copperheadhq/copperhead-tps5430-buck-converter/docs/README.md

# Documentation

The design documents of the TPS5430 12 V to 5 V Industrial Buck Converter at rev E (release commit `c50e737`, design at `116202e`), published as they were written alongside the design.

| File | What |
| --- | --- |
| `BRIEF.md` | the brief the design was built from, unedited |
| `BOM.md` | design document from the workspace, unedited |
| `CHANGELOG.md` | design document from the workspace, unedited |
| `DECISIONS.md` | design document from the workspace, unedited |
| `PINOUT.md` | design document from the workspace, unedited |
| `SPEC.md` | design document from the workspace, unedited |
| `SUBSYSTEMS.md` | design document from the workspace, unedited |
| `BOARD-STATS.md` | measured board statistics: parts, pads, holes, vias, track widths, pours, teardrops, DRC and ERC |
| `schematic.pdf`, `schematic.svg` | the schematic, exported from `hardware/` with KiCad 10.0.6. Regenerate rather than edit |

These documents record choices as they were made, and name files that are not in this repository: `outputs/`, `openspec/`, `releases/`, `research/`, `docs/LAYOUT.md`, `docs/DEVPLAN.md` and `.copperhead/constraints.json`. The rev E fabrication files from `releases/rev-e/` are in [`../fab/rev-e/`](../fab/rev-e/); the earlier rev D files stay in [`../fab/rev-d/`](../fab/rev-d/).
