copperheadhq/copperhead-tps5430-buck-converter/docs/DECISIONS.md

- 2026-11-05 [run 2026-11-05T21-28-54-613Z] Seeded docs/SPEC.md from docs/BRIEF.md and filled the budgets the brief leaves unstated with ASSUMED defaults: Vout ±3 % (4.85–5.15 V); ripple ≤50 mVpp; efficiency ≥85 % at 12 V/3 A; no-load Iin ≤20 mA; shutdown Iin ≤1 mA; LED 1–3 mA; reverse-FET |Vgs| target ≤15 V (20 V abs); component voltage derating ≥1.5×; TPS5430 Tj ≤125 °C; component rise ≤40 °C; terminals ≥4.5 A; power copper ≤20 °C rise; clearance ≥0.2 mm; M3 keepout ≥3.5 mm radius; passives ≥0603. The fuse value (3 A vs 4 A) stays an open question, with 0154004.DRT recommended. | why: Later stages need numeric budgets to check parts against. These are conventional defaults for a 15 W SELV buck, and each one is flagged ASSUMED so the person can override it. | affects: docs/SPEC.md; .copperhead/constraints.json; F1, Q_rev, U1, L1, D_catch, C_in, C_out, J1, J2, LED
- 2026-11-05 [run 2026-11-05T21-32-46-743Z] TVS D1 (SMBJ18A) is placed on the protected side of the reverse-polarity FET Q1. The input order is J1 → F1 → Q1 → D1. | why: A unidirectional TVS ahead of Q1 would forward-conduct on a reversed supply and blow F1, which breaks the requirement of no damage from -18 V. Placing it downstream means Q1's channel carries the surge current, so the parts stage must check Q1's pulsed Id against the SMBJ18A Ipp. | affects: D1, Q1, F1, VIN_PROT, docs/SUBSYSTEMS.md §1
- 2026-11-05 [run 2026-11-05T21-32-46-743Z] EN has no external pull-up. The TPS5430 internal ENA pull-up gives the default-on state, and external control is open-drain or dry contact to GND only, via 2 pads plus TP_EN. An optional DNP 1 nF EN→GND footprint is provided. | why: ENA abs max is about 7 V (VERIFY) [corrected 2026-11-06, change review-docs-fab-notes: 7 V abs max and 1.5 MΩ internal pull-up, TI SLVS632L rev L, VERIFIED], so a pull-up to VIN (9–29 V) would overstress the pin, and no other rail exists before the converter starts. The internal pull-up meets SPEC 'pulled high by default' and adds nothing to the 1 mA shutdown budget. The missing pull-up is intentional, not an omission. | affects: U1 ENA, EN net, R_en (deliberately not fitted), docs/SUBSYSTEMS.md §5, SPEC §3 EN
- 2026-11-05 [run 2026-11-05T21-32-46-743Z] Specify feedback resistors R2 10.0 kΩ and R3 3.24 kΩ at 0.5 % tolerance (or tighter), 0603, ≤50 ppm/°C, instead of the 1 % stated in the brief. The values are unchanged. | why: With 1 % parts, the TPS5430 reference (±1.5 %, VERIFY) plus the divider ratio error (±1.5 %) already uses the whole ±3 % (4.85–5.15 V) budget, leaving no room for line, load or ripple error. At 0.5 % the worst case is about ±2.3 % plus regulation error. | affects: R2, R3, FB, power.vout_V, docs/SUBSYSTEMS.md §4, docs/BRIEF.md Parts (deviation from 1 %)
- 2026-11-05 [run 2026-11-05T21-36-28-544Z] Stage 3 part selection: (a) D1 SMBJ18A-13-F is drawn with Device:D_Zener (K=1 on VIN_PROT, A=2 on GND) because no unidirectional TVS symbol is installed and Device:D_TVS is bidirectional (A1/A2). (b) L1 SRP1265A-150M uses footprint Inductor_SMD:L_Bourns_SRP1245A because no SRP1265A footprint is installed (same 12.5x12.5 mm SRP12xx body [corrected 2026-11-06, change review-docs-fab-notes: the SRP1265A body is 13.5 × 12.5 mm, Bourns SRP1265A rev 06/24, VERIFIED; long side along the pad axis, inside the courtyard]; pads must be compared with the SRP1265A datasheet before layout). (c) J1/J2 change from Würth 691137710002 to Phoenix MKDS 1,5/2-5.08 (1715721) because no Würth footprint is installed; the Phoenix part is rated ~17.5 A, well above 4.5 A. (d) Q1 DMP6023LE uses Transistor_FET:Q_PMOS_GDS (SOT-223 G/D/S, tab=D). (e) FB1 is a 2512 0 Ω jumper (RCL12250000Z0EG) for the bridged EMI series position. All MPNs UNVERIFIED. Leakage roll-up: shutdown about 0.11 mA (≤ 1 mA), no-load about 6–10 mA (≤ 20 mA). | why: Stage 4 can only draw installed symbols and footprints. Keeping the unidirectional K/A polarity explicit preserves the reverse-polarity analysis. A footprint that matches the actual MPN avoids pad and pitch mismatch. All budgets still hold. | affects: D1, L1, J1, J2, Q1, FB1, docs/BOM.md, docs/SPEC.md §5, docs/SUBSYSTEMS.md, deviation from docs/BRIEF.md Parts (terminals)
- 2026-11-05 [run 2026-11-05T21-40-51-050Z] Stage 4 schematic capture from schematic.intent.json, with these choices:
(a) D1 SMBJ18A stays Device:D_Zener (K=1 on VIN_PROT, A=2 on GND). The dossier suggested Diode:SMAJ18A, which was rejected because it has bidirectional A1/A2 pins and would hide the unidirectional polarity the reverse-polarity analysis depends on.
(b) Parts the dossier marked as having no installed MPN symbol (Q1, F1, D2, D3, D4, FB1, J1–J3, TP1–TP7) use the generic installed lib_ids from BOM.md. verify_symbols confirmed all 13 of them.
(c) LED_A is a new net, the R4 to D4 anode node, added beyond the SUBSYSTEMS planned list.
(d) U1.2 and U1.3 (NC) are explicit no-connects. There is still no EN pull-up (protection.ena_pin_max_V).
(e) verify_symbols reports wrong-library on the power symbols the engine generates: copperhead_power:+5V, GND, PWR_FLAG and VIN_BUCK, where it expects power:*. The IR cannot set these and edit_file is refused on the drafted sheet, so this is left as a known drafting-engine issue. ERC is clean. Retarget the symbols to power:* before netlist export to layout.
(f) A3 paper was kept despite the low-utilization advisory. | why: Keeps the protection polarity explicit and uses only installed, pin-verified symbols. It also records the one verification finding that is open but outside the IR's control, so layout does not miss it. | affects: D1, Q1, F1, D2, D3, D4, FB1, J1–J3, TP1–TP7, U1.2, U1.3, LED_A, EN, power symbols, docs/PINOUT.md, tps5430-12-v-to-5-v-industrial-buck-converter.kicad_sch
- 2026-11-05 [run 2026-11-05T22-11-48-485Z] Stage 5 first-draft layout. (a) Edge.Cuts resized to 55 × 35 mm, (100,100)–(155,135). (b) Two-band placement: input chain J1 (left edge) → F1 → Q1 (rot 180, tab to F1) → D1 → FB1 across the top, and J2 on the right edge. The buck core is in the bottom band: U1 (126,126.5) with C3 at VIN pin 7, C4 between BOOT and PH, D3 (rot 270) right of C3, and L1 in the bottom-right corner. C5/C6 sit between L1 and J2. The R2/R3/TP6 feedback divider is left of VSENSE, away from SW. (c) Only BOOT, the SW bootstrap leg, FB, VIN_RAW, VIN_FUSED, the VIN_BUCK HF bypass and LED_A are routed (52 → 44 unrouted). No GND pour yet. VIN_PROT, the VIN_BUCK bulk path, SW to D3/L1 and +5V are left as ratsnest for a specialist pass. (d) TP4 is placed in the lower-left strip, not at J2, for lack of space. (e) No M3 mounting holes are placed, because no mounting-hole footprints exist in the schematic/BOM. They have to be added through the schematic. (f) 25 silkscreen warnings are left and listed in LAYOUT.md. | why: Keeps the protection order and the tight VIN–C3–U1–D3 loop that the architecture requires, while staying DRC-error-free within the 55 × 35 mm envelope. The unrouted high-current copper and the missing GND pour are recorded as non-optimal items in docs/LAYOUT.md Draft quality, not left unlabelled. | affects: J1, J2, F1, Q1, D1–D4, L1, FB1, C1–C9, R1–R4, J3, TP1–TP7, U1, Edge.Cuts, docs/LAYOUT.md, tps5430-12-v-to-5-v-industrial-buck-converter.kicad_pcb
- 2026-11-05 [run 2026-11-05T22-46-32-892Z] F1 changes from Littelfuse 0154003.DRT (3 A) to 0154004.DRT (4 A slow-blow). The OMNI-BLOK holder, the footprint Fuse:Fuseholder_Littelfuse_Nano2_154x and the nets VIN_RAW/VIN_FUSED do not change. SPEC §9 Q1 is closed as decided. FB1, or any series inductor or ferrite fitted there later, must now be rated at least 4 A instead of 3 A; the RCL12250000Z0EG at about 7 A class still passes. The schematic Value was changed through schematic.intent.json and a re-draft, because the sheet is engine-drafted and direct edits are refused. The board F1 Value text was changed in place, with no pad, net or position change. | why: At the 1.96 A worst-case input the 3 A fuse ran at about 87 % of rating, above the 75 % continuous guideline and worse at 50 °C. The 4 A fuse runs at about 49 %. The fuse also has to open before the series link fails, so FB1's required rating rises with it. The change follows docs/BRIEF.md Parts (decided 2026-11-05, research/parts/input-fuse.md). | affects: F1, FB1, J1, Q1, PCB input copper, protection.fuse_rating_A, schematic.intent.json, tps5430-12-v-to-5-v-industrial-buck-converter.kicad_sch, tps5430-12-v-to-5-v-industrial-buck-converter.kicad_pcb, docs/BOM.md, docs/SPEC.md §3 and §9, docs/SUBSYSTEMS.md §0, §1, §2 and §9, docs/PINOUT.md
- 2026-11-05 [run 2026-11-05T22-49-58-758Z] L1 footprint Inductor_SMD:L_Bourns_SRP1245A is accepted as VERIFIED for the SRP1265A-150M. The SRP1265A and SRP1245A datasheets give the same recommended land pattern: 14.2 mm overall, 8.0 mm gap, 5.0 mm pad width. The KiCad pads are 3.1 × 5 mm at ±5.55 mm, which matches. Body height differs (SRP1265A 6.2 mm vs SRP1245A 4.8 mm), so the 3D model is 1.4 mm short. Copper is unaffected. LAYOUT.md Draft quality item 10 is closed. No footprint, net, schematic or board change. L1 electrical figures (Isat, Irms, DCR) stay UNVERIFIED. | why: The copper matches the manufacturer's recommended layout, so the pad-mismatch risk from stage 3 is gone. The height difference only matters for enclosure and height clearance, so it stays recorded as a note. | affects: L1, docs/BOM.md, docs/LAYOUT.md item 10
- 2026-11-05 [run 2026-11-05T22-56-18-542Z] The schematic keeps the copperhead_power:* power symbols (+5V, GND, PWR_FLAG, VIN_BUCK). This is an accepted drafting-engine limitation, and they will not be retargeted to power:*. docs/LAYOUT.md Draft quality item 11 is closed. This supersedes the stage-4 decision (e) instruction to retarget them before netlist export. The verify_symbols wrong-library finding on these four symbols is expected and needs no action. No schematic, net, board or constraint change. Accepted by the person on 2026-11-05. | why: The drafting engine can only place copperhead_power symbols. They are genuine KiCad power symbols in a project library, so they give the same nets and netlist as power:* would. KiCad has no stock power:VIN_BUCK, so a full retarget is not possible anyway. | affects: +5V, GND, PWR_FLAG, VIN_BUCK power symbols; tps5430-12-v-to-5-v-industrial-buck-converter.kicad_sch (unchanged); docs/LAYOUT.md item 11; docs/DECISIONS.md stage-4 (e)
- 2026-11-05 [run 2026-11-05T22-56-59-643Z] Added M3 mounting holes H1 (103,103) top-left and H2 (157,137) bottom-right, diagonally opposite. Both are Mechanical:MountingHole with footprint MountingHole:MountingHole_3.2mm_M3, NPTH, no net. They were added through schematic.intent.json (new SUBSYSTEMS §10 Mechanical group) and BOM.md rows. Each footprint carries an embedded keepout rule area, a 16-gon with 3.57 mm circumscribed radius so the inner radius is ≥ 3.5 mm, on F.Cu and B.Cu. It forbids tracks, vias, copper pour and footprints. Pads are allowed only so the hole's own NPTH pad does not flag. To free the bottom-right corner, the Edge.Cuts outline grew from 55 × 35 to 60 × 40 mm, (100,100)–(160,140). That corner was blocked: L1's courtyard reaches x 154.7 / y 134.5 and D3 blocks a slide left. J1 slid down the left edge to (106,115.5), with the VIN_RAW stub re-anchored. J2 slid right to (154,104). TP3 moved to (106,121.5). U1, C3, C4, D3, L1 and R2/R3/TP6 did not move. The two DRC lib_footprint_mismatch warnings on H1/H2 are intentional. mech.board_mm max is updated from 55 to 60. | why: docs/BRIEF.md Physical requires 2 × M3 on opposite corners with copper and component keepout. Growing the outline to the person's 60 × 40 mm limit was the only way to free a second corner without breaking the tight VIN–C3–U1–D3 loop or moving the FB divider toward SW. Embedding the keepout in the footprint avoids a board-level zone flagging the hole's own courtyard. The holes are unplated and unbonded so the mount is not a GND path. DRC shows 0 errors, unrouted stays at 44, and ERC is clean. | why: Meets the brief's mounting-hole and keepout requirement within the agreed size limit while leaving the buck hot loop and feedback placement untouched. | affects: H1, H2, J1, J2, TP3, VIN_RAW track, Edge.Cuts, mech.board_mm, schematic.intent.json, .kicad_sch, .kicad_pcb, docs/BOM.md, docs/SUBSYSTEMS.md §10, docs/LAYOUT.md (outline, placement, item 8), docs/SPEC.md §6 and §9 Q2, docs/PINOUT.md
- 2026-11-05 [run 2026-11-05T22-56-59-643Z] Supersedes the earlier entry today on H1/H2 keepouts. H1 (103,103) and H2 (157,137) now use the unmodified stock MountingHole:MountingHole_3.2mm_M3 footprints. Their keepouts are board-level rule areas on F.Cu and B.Cu. Each hole has a full r ≥ 3.5 mm copper-keepout disc (16-gon, 3.57 mm circumscribed) that forbids tracks, vias and copper pour but allows footprints and pads. Each hole also has a half-annulus pair (≈ 3.48–3.8 mm) that forbids footprints, sitting just outside the hole's own 3.45 mm courtyard. The embedded-in-footprint keepout from the first attempt is removed. The two lib_footprint_mismatch DRC warnings it caused are gone, and DRC is clean with 44 unrouted. | why: A keepout embedded in the stock footprint made it differ from the library copy, which raised lib_footprint_mismatch. A single board-level zone with footprints not_allowed would flag the hole's own courtyard. A copper disc plus a component annulus outside the hole courtyard enforces both keepouts with clean DRC. | affects: H1, H2, board keepout zones H1_*/H2_*, mech.board_mm, docs/LAYOUT.md item 8 and H1/H2 rows, docs/CHANGELOG.md, earlier DECISIONS entry of this run
- 2026-11-05 [run 2026-11-05T23-26-09-525Z] Added two unfilled GND zone outlines, GND_pour_F.Cu and GND_pour_B.Cu. Each is a rectangle (100.5,100.5)–(159.5,139.5), inset 0.5 mm from Edge.Cuts. Settings: net GND, thermal-relief pad connection (gap 0.5 mm, spoke 0.5 mm), zone clearance 0.3 mm, min thickness 0.25 mm. The existing H1_/H2_copper_keepout_r3.5 rule areas (copperpour not_allowed) carve the pours around the mounting holes. U1 pad 9 (the exposed pad and its footprint thermal-via pads) connects solid to GND through a new rule, U1_pad9_solid_to_GND, in the existing project .kicad_dru, which also keeps its via-drill rule. I also added an explicit (stackup) to the board (setup): F.Cu and B.Cu 0.07 mm (2 oz), 1.44 mm FR4 core, 0.01 mm mask each side, 1.6 mm overall. Design rules are otherwise unchanged. No stitching vias were added and the zones were not filled; KiCad's filler (kicad-cli pcb drc --refill-zones --save-board) must fill them, and stitching vias come in a later change. DRC is clean with 44 unrouted (unchanged), the only finding being the pre-existing FB1 library-internal silk. ERC and drift are clean. | why: docs/BRIEF.md Physical asks for large pours and 2 oz copper (pcb.copper_oz), and thermal.tj_max_C needs the PowerPAD bonded solid to GND. A DRC rule gives the solid connection without modifying the stock U1 footprint, which avoids lib_footprint_mismatch. Thermal relief on the other pads keeps them hand-solderable at 2 oz. A 0.3 mm zone clearance exceeds the 0.2 mm pcb.min_clearance_mm and suits 2 oz fab capability. | affects: GND net, U1 pad 9, H1/H2 keepouts, board stackup, tps5430-12-v-to-5-v-industrial-buck-converter.kicad_pcb, tps5430-12-v-to-5-v-industrial-buck-converter.kicad_dru, docs/LAYOUT.md items 1 and 12, docs/SPEC.md §6, docs/CHANGELOG.md
- 2026-11-06 [run 2026-11-05T23-31-02-207Z] Change route-high-current-paths (2026-11-06) routes the high-current nets on 2 oz copper. (a) Placement: D1 and FB1 flipped from 90° to 270° so VIN_PROT runs as one straight 2.0 mm F.Cu row at y 103.7, Q1.3 → D1.1 → FB1.1. This closes LAYOUT item 3. TP1 moved to (128, 114.5) and sits on a 1.0 mm VIN_PROT spur that also feeds D2.1 and C7.1. C1 moved from (134, 120.6) to (131.4, 129) 270°, between U1's right-hand pins and D3. Its VIN pad is ~1.6 mm from U1.7, and a direct 1.5 mm GND link runs to the D3 anode. A first attempt at (133.8, 126.6) 0° shorted to C3 GND and D3 SW and was replaced. D3 and C2 did not move. (b) VIN_BUCK: 1.5 mm F.Cu trunk FB1.2 → C2. It crosses under the SW run on a 2.0 mm B.Cu segment through 3 + 3 vias (0.8/0.4 mm), then feeds C1.1 (1.0 mm) and C3.1 (0.8 mm). U1.7 → C3.1 widened from 0.5 to 0.8 mm. (c) SW: U1.8 → D3.1 → L1.1 on 1.0–2.5 mm F.Cu. SW zone outlines are priority 1 above GND: F.Cu (135,120)–(143.8,131) minus the D3 anode corner, and B.Cu (135,120)–(143.8,134). Four SW vias stitch them, for ≈ 2.1 cm² of outline. The zones are UNFILLED like the GND pours; measure the filled area after the KiCad fill. (d) +5V: L1.2 → C6 → TP2/J2.1 on 2.0–2.5 mm, with a 2.0 mm branch to C5+. (e) R2.1 gets a dedicated 0.25 mm Kelvin trace from the C5 + pad, B.Cu along y 116.8 and x 117.3, kept away from SW. R4 gets its own 0.3 mm feed from C5+. (f) All remaining GND connections are left to the unfilled pours. DRC clean with unrouted 44 → 24. ERC clean. | why: Meets power.iout_A 3 A at ≤ 20 °C rise on 2 oz (pcb.copper_oz): IPC-2221 needs ≈ 0.6 mm, and main runs are 1.5–2.5 mm. Every series input element carries ≥ 4 A (protection.fuse_rating_A). The PCB-only reroute keeps the VIN–C1/C3–U1–D3 loop tight without moving the U1 core or the FB divider. SW copper area serves thermal.component_rise_C for D3. No value, net or footprint changes, so power.output_filter_compensation is untouched. | affects: D1, FB1, TP1, C1, C8/C9/FB1 reference labels, VIN_PROT, VIN_BUCK, SW, +5V, Q1_GATE, GND (C1–D3 link), R2.1 Kelvin, R4 feed, SW_copper_F.Cu, SW_copper_B.Cu, tps5430-12-v-to-5-v-industrial-buck-converter.kicad_pcb, docs/LAYOUT.md items 2–6, docs/CHANGELOG.md
- 2026-11-06 [run 2026-11-06T00-36-24-166Z] Change route-remaining-signals-silkscreen (2026-11-06). (a) EN routed U1.5 → C9.1 → J3.1 → TP7 on 0.3 mm F.Cu below U1, away from SW; still no pull-up. (b) FB legs R2.2 → R3.1 → TP6 on 0.25 mm F.Cu, left of U1; R2.1 Kelvin feed unchanged. (c) GND links added where a filled pour would reach a pad badly or not at all: U1.6 → pad 9 (F.Cu 0.5 mm); C3.2 in-pad via + 0.5 mm B.Cu to pad 9; D3 anode 1.5 mm drop to a strapped via pair at (135.9/136.9, 135.5) below the B.Cu SW zone; D1.2 strapped via pair at (136.5/137.5, 108.6); TP4 → J2.2 0.5 mm. A C8.2 via was tried and removed, because no position clears both the B.Cu +5V Kelvin trace and the VIN_BUCK copper; C8 is DNP, so this is left as a post-fill check. (d) TP4 moved from (116,133) to (147.5,110) beside J2 pin 2. (e) F.SilkS labels J1 +VIN/-GND, J2 +5V/-GND and TP1–TP7 names; C5, L1, D3 and C6 reference labels moved out from under the part bodies. DRC clean, 16 unrouted (all GND, for the pours), ERC and drift clean. No net, value, footprint or schematic change. | why: Leaves only GND connections, which the pours will make, as ratsnest. Gives the hot-loop and TVS returns a direct path to the B.Cu pour that does not depend on thin F.Cu necks. Meets docs/BRIEF.md Physical silkscreen requirements and closes LAYOUT items 7 and 9 without touching the compensation, EN or keepout constraints. | affects: EN, FB, GND, U1.5, U1.6, C3, C9, J3, TP4, TP6, TP7, D1, D3, C8 (DNP), J1/J2 silk, C5/L1/D3/C6 reference labels, tps5430-12-v-to-5-v-industrial-buck-converter.kicad_pcb, docs/LAYOUT.md items 7 and 9, docs/CHANGELOG.md
- 2026-11-06 [run 2026-11-06T00-55-43-290Z] Change q1-pin2-r1-gnd-links (2026-11-06). (a) A 1.5 mm F.Cu VIN_FUSED link along y 106 joins Q1 pin 2 (132.15,106) to the Q1 tab (125.85,106), the two pads numbered 2 on SOT-223-3_TabPin2. It has 0.8 mm clearance to pin 1 (Q1_GATE) and pin 3 (VIN_PROT). (b) To free y 106, the VIN_PROT spur stretch under Q1 (x 129, y 103.7 to 108.5) moved to 1.0 mm B.Cu between 0.8/0.4 mm vias at (129,103.7) and (129,108.5). (c) A 0.5 mm F.Cu GND trace runs from R1.2 (136.825,112) to the existing D1.2 GND via at (136.5,108.6). DRC is clean with 14 unrouted (16 before), and ERC is clean. | why: After the zone fill, KiCad reports Q1 pin 2 as unconnected and R1.2 as having one thermal spoke where the zone minimum is 2. A link wider than 1 mm keeps the input path at ≥ 4 A so the fuse opens first (protection.fuse_rating_A). The spur only carries clamp, test-pad and DNP-shunt current, so moving it through vias costs nothing. The R1.2 trace joins the via pair that already ties the TVS return to the B.Cu pour, so R1.2 no longer depends on the F.Cu pour. | affects: Q1, R1, D1 GND vias, VIN_FUSED, VIN_PROT spur, GND, tps5430-12-v-to-5-v-industrial-buck-converter.kicad_pcb, docs/LAYOUT.md, docs/CHANGELOG.md
- 2026-11-06 [run 2026-11-06T01-00-34-572Z] Change r1-solid-gnd-stitching-vias (2026-11-06). (a) R1 pad 2 (GND) gets a pad-level (zone_connect 2) solid override in the .kicad_pcb to clear DRC starved_thermal (F.Cu pour gave 1 spoke, zone minimum 2). A .kicad_dru zone_connection solid rule scoped to R1 pad 2 was tried first, with and without the B.Type == 'Zone' condition; DRC still reported starved_thermal, so the rule was removed and replaced by a comment. The board-wide zone minimum spoke count stays 2, and DRC shows no lib_footprint_mismatch. (b) U1_pad9_solid_to_GND uses the same rule form, so it may not be taking effect; flagged OPEN in LAYOUT.md to confirm in KiCad after the refill (thermal.tj_max_C), with the same pad-level override as the fallback. (c) 34 GND stitching vias, 0.6 mm pad / 0.3 mm drill (uuid prefix 5717c400-000b): edges at 5 mm pitch (top y 101.5 x 110–145, bottom y 138.5 x 105–150, left x 101.5 y 120–135, right x ≈158.5 y 116/123/128), all outside the H1/H2 copper keepouts; power stage: three below U1 pad 9 (124.6/126/127.4, 130.4), one on the C1.2→D3 GND link (133.4, 131.445), two flanking the D3 anode via pair (134.4/138.3, 135.5), one east of C2.2 (137, 118.3), two south of C5−/C6.2 (147/149.5, 120.3). All outside both SW zones and clear of the B.Cu +5V Kelvin/R4 feeds, VIN_BUCK, EN and FB. Zone fills not edited; DRC clean, 0 unconnected, ERC and drift clean. | why: The person forbade lowering the board-wide spoke minimum, and the DRC rule demonstrably did not reach the starved_thermal check, so a single-pad override is the narrowest fix that works; R1 carries < 0.2 mA, so a solid joint has no electrical or rework cost. Stitching vias tie the F.Cu and B.Cu pours together at the edges and at the hot-loop and output returns (docs/BRIEF.md Physical, pcb.copper_oz, thermal.tj_max_C, thermal.component_rise_C) without entering the SW copper or the mounting-hole keepouts (mech.board_mm). Placing them only in existing GND fill keeps the current fill valid until KiCad refills. | affects: R1 pad 2, U1 pad 9 (open check), GND net, GND_pour_F.Cu, GND_pour_B.Cu, SW_copper zones (avoided), H1/H2 keepouts (avoided), tps5430-12-v-to-5-v-industrial-buck-converter.kicad_pcb, tps5430-12-v-to-5-v-industrial-buck-converter.kicad_dru, docs/LAYOUT.md, docs/CHANGELOG.md
- 2026-11-06 [run 2026-11-06T01-09-20-998Z] Stage 6 outputs package (change outputs-package-stage6). (a) Fab files come from export_outputs (kicad-cli, KiCad 10.0.6): Protel-extension gerbers plus a gbrjob, one merged PTH/NPTH Excellon drill, outline.dxf, board.step, board.svg and schematic.svg in outputs/. The export_svg sch and pcb renders went to .copperhead/renders/. (b) I am NOT claiming the gerbers were made with the JLC plot profile. export_outputs does not report its profile. The output is JLC-compatible (Protel extensions, metric Excellon, gbrjob showing 2 layers, 1.6 mm, 0.07 mm copper and 0.2 mm clearance), but it also contains Adhesive, User_* and Fab layers, a merged drill file and an unset revision. outputs/README.md lists these differences. (c) outputs/BOM.csv is generated from docs/BOM.md, grouped by MPN, with Refdes, MPN, Qty_per_board, Value, Footprint, Fitted and Note. It has 21 fitted placements. DNP parts (C7, C8, C9, J3) and the no-part items (TP1–TP7, H1, H2) appear at Qty 0 on purpose, so their absence reads as intentional. (d) These are recorded as pre-fab blockers, not fixed in this run: U1 pad 9 solid connection still OPEN (thermal.tj_max_C); refill the zones after the stitching vias, then re-export; order 2 oz in the JLC form; no CPL or JLC-format BOM; every MPN UNVERIFIED. No schematic, board, net, value or footprint change. | why: The person asked for the JLC profile and for every export to succeed. All exports did succeed, but whether the JLC profile was used cannot be verified from the tool output, so it is reported as unconfirmed rather than assumed. The 0-qty rows stop an assembler or reviewer from treating DNP parts or bare pads as missing. The open thermal and zone-fill items affect what copper the gerbers actually contain, so they must be checked before ordering. | affects: outputs/gerbers/*, outputs/*.drl, outputs/outline.dxf, outputs/board.step, outputs/board.svg, outputs/schematic.svg, outputs/BOM.csv, outputs/README.md, U1 pad 9, GND zones, assembly.qty, pcb.copper_oz, thermal.tj_max_C, docs/CHANGELOG.md
- 2026-11-06 [run 2026-11-06T01-13-58-512Z] Change u1-pad9-solid-zone-connect (2026-11-06). All 11 U1 pads numbered 9 have a pad-level (zone_connect 2) solid override in the .kicad_pcb: the 2.6 × 3.1 mm exposed SMD pad, the 2.95 × 4.5 mm F.Cu and B.Cu pad copper, and the 8 thermal-via pads (0.6 mm, 0.3 mm drill). The ineffective .kicad_dru rule U1_pad9_solid_to_GND was removed and replaced by a comment; the via-drill rule is unchanged. Zones and fills were not edited, and the zone default stays thermal relief for every other pad. DRC is clean (0 unconnected, no lib_footprint_mismatch; only the pre-existing FB1 library-internal silk). ERC and drift are clean. This supersedes the 2026-11-05 gnd-zones-2oz-stackup choice of a DRC rule for pad 9, and closes the LAYOUT.md open item. | why: thermal.tj_max_C needs the PowerPAD bonded solid to the GND pours, and the rule form had already failed to take effect for R1 pad 2. The pad-level override is the fix that worked there, and it is scoped to U1 pad 9 only, so the board-wide thermal-relief default is unchanged. | affects: U1 pad 9 (11 pads), GND net, GND_pour_F.Cu, GND_pour_B.Cu, tps5430-12-v-to-5-v-industrial-buck-converter.kicad_pcb, tps5430-12-v-to-5-v-industrial-buck-converter.kicad_dru, docs/LAYOUT.md, docs/SPEC.md §6, docs/CHANGELOG.md, earlier DECISIONS entry (gnd-zones-2oz-stackup)
- 2026-11-06 [run 2026-11-06T01-24-14-451Z] Change bom-jlcpcb-lcsc-sourcing (2026-11-06). docs/BOM.md gains an LCSC column as the last column (Refdes, Value, Footprint stay first). It is filled for every fitted part: U1 C9864, Q1 C154901, F1 C206915, D1 C135055, D2 C124196, D3 C85100, D4 C6848499, L1 C189912, FB1 C346503, C1/C2 C77102, C3 C14663, C4 C57112, C5 C341198, C6 C21397, R1 C25803, R2 C95204, R3 C728589, R4 C22843, J1/J2 C480516. It is empty on purpose for C7, C8, C9, J3 (not fitted), TP1–TP7 and H1/H2 (not parts). MPN changes, with values and footprints unchanged: FB1 RCL12250000Z0EG → Stackpole HCJ2512ZT0R00 (63.2 A; the RCL1225 is a 1225 wide-terminal package that does not fit R_2512_6332Metric). C3 → CC0603KRX7R9BB104. C4 → 0603B103K500NT. C5 EEH-ZA1A221P → EEH-ZA1E221P (25 V, ESR 27 mΩ per listing). C6 GRM32ER71A226KE20L → GRM32ER71E226KE15L (25 V). R1 → 0603WAF1003T5E. R2 → RT0603BRD0710KL and R3 → RT0603BRD073K24L (both 0.1 %, 25 ppm). R4 → 0603WAF1501T5E. Listing-only figures are corrected and kept UNVERIFIED: D1 IR ≤ 5 µA (was assumed ≤ 1 µA), so shutdown is ≈ 0.115 mA against the 1 mA budget; D2 is 370 mW (was 500 mW); L1 Isat 12.5 A / Irms 9 A / DCR 28 mΩ. Compensation re-check (power.output_filter_compensation): the C5 ESR zero moves from ~24 kHz to ~27 kHz (+11 %), the LC pole stays ≈ 2.6 kHz, there is still one output ceramic, and ripple is ≈ 13 mVpp (ESR far below 80 mΩ). The constraint is satisfied on paper; confirm on the datasheet and the bench. outputs/BOM.csv is updated to match. The schematic, intent file and board hold no MPN fields, so no KiCad file changed. docs/BRIEF.md Parts still names EEH-ZA1A221P and GRM32ER71A226KE20L (10 V). It is left as the person's source, and this entry records the deviation. | why: docs/BRIEF.md Physical calls for JLCPCB assembly, and research/parts/jlcpcb-sourcing.md (chosen 2026-11-06) gives stocked LCSC parts. The substitutes meet or beat the originals: higher voltage on C5/C6 (better derating), tighter R2/R3, and an FB1 that actually fits its land and carries far more than the 4 A fuse. The C5 ESR move is small and in the same ZA series, so the internally compensated loop stays near TI's reference filter. | affects: FB1, C3, C4, C5, C6, R1, R2, R3, R4, D1, D2, L1, all fitted parts (LCSC), docs/BOM.md, docs/SUBSYSTEMS.md §1/§2/§4/§9, docs/SPEC.md §3, outputs/BOM.csv, power.output_filter_compensation, power.iin_shutdown_mA, components.voltage_derating, docs/BRIEF.md Parts (deviation, not edited)
- 2026-11-06 [run 2026-11-06T01-31-33-262Z] Change outputs-reexport-post-refill (2026-11-06). export_outputs re-ran after the KiCad refill (person-reported commit 70ca14b, U1 exposed pad solid to GND). All six artifacts succeeded: gerbers, drill, outline.dxf, board.step, board.svg, schematic.svg. The export_svg sch and pcb renders in .copperhead/renders/ were also regenerated. Pre-export DRC in this run was clean, with only the FB1 library-internal silk_over_copper finding. outputs/BOM.csv was regenerated from docs/BOM.md with an LCSC column added last. LCSC numbers moved out of the Note cells into that column. DNP (C7, C8, C9, J3) and no-part items (TP1–TP7, H1, H2) stay at Qty 0 with an empty LCSC cell on purpose. Listing-only figures (D1 IR, D2 370 mW, L1 Isat/DCR, C5 ESR) are noted UNVERIFIED. outputs/README.md closes the zone-fill and U1 pad 9 items. It states that the JLCPCB BOM comes from `copperhead export bom` and the CPL from /release-board. It keeps these open checks: order 2 oz on the JLC form, plot profile unconfirmed, FB1 silk, UNVERIFIED listing figures, through-hole J1/J2 and the OMNI-BLOK F1, and bench validation. No board, schematic, net, value or footprint change. | why: The previous package predated the refill and the LCSC sourcing, so its gerbers did not carry the solid pad-9 copper and its BOM lacked LCSC numbers. Re-exporting from the DRC-clean refilled board makes the fab package match the design. Closed items rest on the person's refill report and are backed by this run's DRC. Checks this export cannot prove stay listed. | affects: outputs/gerbers/*, outputs/*.drl, outputs/outline.dxf, outputs/board.step, outputs/board.svg, outputs/schematic.svg, outputs/BOM.csv, outputs/README.md, .copperhead/renders/, U1 pad 9, GND zones, thermal.tj_max_C, pcb.copper_oz, assembly.qty, docs/CHANGELOG.md
- 2026-11-06 [run 2026-11-06T01-35-30-022Z] Change bom-d2-remove-escaped-pipes (2026-11-06). In the docs/BOM.md D2 rationale, the phrase with escaped pipes around Vgs was rewritten as 'the gate-source voltage magnitude stays at or below 12 V' [corrected 2026-11-06, change review-docs-fab-notes: D2 BZT52C12 Vz is 11.4–12.7 V at 5 mA, Diodes DS18004 rev 38-2, VERIFIED, so the bound is 12.7 V; docs/BOM.md already reads 12.7 V], with no pipe character. D2's LCSC cell holds C124196 (research/parts/jlcpcb-sourcing.md). A scan of docs/BOM.md found no other escaped pipe, and no parts-table row with more than seven separators. The clamp value (12 V) and every other figure are unchanged. outputs/BOM.csv was not regenerated in this run. Docs only: no schematic, board, net, value, footprint or constraint change. Drift is clean. | why: Markdown table parsers, including copperhead export bom, split cells on pipes even when they are backslash-escaped, so D2's LCSC number exported as 'Vgs\'. Wording without pipes keeps the meaning and keeps the table at a fixed column count. | affects: D2, docs/BOM.md (D2 row), copperhead export bom / outputs/BOM.csv (re-export pending), docs/CHANGELOG.md
- 2026-11-06 [run 2026-11-06T01-37-27-684Z] Change devplan-rev-a (2026-11-06). Added docs/DEVPLAN.md as the rev A development plan. §0: rev A has no firmware. There is no MCU, programmable logic or configuration memory, and docs/BRIEF.md Must not and SPEC §8 rule out digital control, telemetry and remote sensing (safety.selv_only). firmware/ intentionally holds only its README.md, and no src/pins.h is generated because PINOUT.md has no MCU pins. §1: layout design review against docs/LAYOUT.md Draft quality, which also flags stale LAYOUT.md text (55 × 35 mm in Fine, the removed U1_pad9 rule in item 1, the pre-fill Unrouted paragraph) for a later docs change. §2: verification table for every UNVERIFIED BOM figure, each mapped to the constraint it protects. §3: ordering. Re-export outputs/BOM.csv (it predates the D2 pipe fix), release with /release-board for the CPL, select 2 oz copper by hand on the JLCPCB form, and handle the through-hole J1/J2. §4: bring-up tests T0–T12, each citing its SPEC section and constraint key. The load-step test T6 records results against power.output_filter_compensation and invents no numeric budget, because SPEC sets none. TVS surge and EMC are explicitly not tested in rev A (SPEC §8). No schematic, board, net, value, footprint or constraint change. | why: The pipeline's devplan stage never ran, because the firmware stage correctly refused for a board with no programmable part. A written plan stops the empty firmware/ tree from looking like an omission. It also ties every validation test to a documented budget instead of ad-hoc pass criteria. | affects: docs/DEVPLAN.md (new), firmware/ (README only, intentional), docs/LAYOUT.md (stale text flagged, not edited), outputs/BOM.csv (re-export pending), docs/CHANGELOG.md
- 2026-11-06 [run 2026-11-06T01-46-44-192Z] Change tp-in-bom-schematic-parity (2026-11-06). Removed exclude_from_bom from the (attr ...) of the TP1–TP7 board footprints, which now read (attr exclude_from_pos_files). This matches the drafted schematic symbols, which the drafting engine always writes as (in_bom yes), and clears the kicad-cli pcb drc --schematic-parity footprint_symbol_mismatch ('Exclude from bill of materials' differs) on all seven test points. exclude_from_pos_files is kept, so the bare test pads stay out of the pick-and-place (CPL) file. The JLCPCB assembly BOM is generated from docs/BOM.md, where TP1–TP7 have no LCSC number and are bare pads, so they stay out of it. KiCad's own BOM export will now list TP1–TP7; that list is not the assembly BOM. A search showed no other footprint carried exclude_from_bom, so the single replace_all touched exactly TP1–TP7. No pad, net, copper, position or other attribute change. DRC clean (only the pre-existing FB1 library-internal silk), ERC clean, drift clean. | why: The schematic side cannot be changed (engine limitation), so the board side must agree for parity. Keeping exclude_from_pos_files and sourcing the assembly BOM from docs/BOM.md keeps unpopulated pads out of both assembly files (assembly.qty). | affects: TP1–TP7 footprints, tps5430-12-v-to-5-v-industrial-buck-converter.kicad_pcb, docs/BOM.md, docs/LAYOUT.md, docs/CHANGELOG.md, assembly.qty, /release-board CPL, copperhead export bom
- 2026-11-06 [run 2026-11-06T01-49-10-797Z] Change fb1-reference-silk-clear (2026-11-06). Moved only the FB1 Reference property (at …) in the .kicad_pcb from local (-4.8, 0, 270) to (-4.6, -0.7, 0). The label is now horizontal at about board (142.5, 101.9), above pad 1 (VIN_PROT, top edge y ≈ 102.9) and between the GND stitching vias at (140, 101.5) and (145, 101.5). This clears the last DRC finding, silk_over_copper on FB1. Earlier changes recorded that finding as library-internal; it was actually caused by where the Reference was placed. No footprint, pad, track, via or zone change. DRC reports no findings, and ERC and drift are clean. | why: The person wants DRC with no warnings left. A label moved into pad 1's mask opening is a placement issue, not a footprint defect, so moving the text is the narrowest fix. Copper and fills are untouched, so pcb.min_clearance_mm and every electrical constraint are unaffected. The label stays readable near FB1 for silkscreen legibility (SPEC §6). | affects: FB1 Reference silkscreen, tps5430-12-v-to-5-v-industrial-buck-converter.kicad_pcb, docs/LAYOUT.md (Fine list, item 9 note), docs/DEVPLAN.md R6, outputs/README.md (FB1 silk open check, stale until re-export), docs/CHANGELOG.md
- 2026-11-06 [run 2026-11-06T02-01-13-387Z] Change bom-datasheet-verification (2026-11-06). docs/BOM.md now records every figure confirmed in research/parts/datasheet-verification.md as VERIFIED, with the datasheet revision and page, and the header line saying every MPN is UNVERIFIED is removed. Corrections: (1) U1 Iq is 2 mA typ, 4.4 mA max (was ~3 mA), so the no-load roll-up is ≈ 7–11 mA worst case against the 20 mA budget. (2) D2 Vz is 11.4–12.7 V, so the Q1 gate-source voltage magnitude is ≤ 12.7 V (15 V target, 20 V abs), clamp current ≤ 66 µA at 18 V, and shutdown is ≈ 0.121 mA against the 1 mA budget. (3) D4 VF is specified at 20 mA (2.0 V typ, 2.4 V max); the 1.9–2.0 V at 2 mA is from the typical curve only, giving 1.9–2.2 mA. (4) L1 body is 13.5 × 12.5 mm and FB1 body 6.40 × 3.20 mm. (5) F1 cold R 18.6 mΩ, I²t 34.4 A²s, ≈ 2.94 A continuous at 50 °C. (6) J1/J2 IEC 17.5 A 250 V (III/3), UL 300 V 10–15 A, 1.3 mm drill matches Phoenix's recommended hole. (7) C1/C2 ≈ 7.4 µF at 18 V; C6 ≈ 17.5–18 µF at 5 V, LC pole ≈ 2.7 kHz. ACCEPTED FOR REV A: the KiCad land patterns for FB1 (R_2512_6332Metric) and C5 (CP_Elec_8x10) are slightly smaller than the makers' recommended lands, with terminations fully on copper. SPEC §2, SUBSYSTEMS §1/§3/§4/§6/§9, DEVPLAN §2 and three constraints carry the same figures. No schematic, board, net, value or footprint change. | why: A manufacturer datasheet beats a listing or an estimate. No corrected figure breaks a budget, so the design stands, but the roll-ups must use the datasheet worst case (4.4 mA Iq, 11.4 V Vz min). Changing the FB1 or C5 footprint would rework power-path copper for a marginal fillet gain on a 5–10 board prototype, so it is deferred unless assembly reports poor fillets. | affects: U1, Q1, F1, D1–D4, L1, FB1, C1–C6, R1–R4, J1, J2, docs/BOM.md, docs/SPEC.md §2, docs/SUBSYSTEMS.md, docs/DEVPLAN.md §2, power.iin_noload_mA, power.iin_shutdown_mA, protection.pfet_vgs_max_V, protection.fuse_rating_A, power.led_current_mA, power.output_filter_compensation
- 2026-11-06 [run 2026-11-06T02-09-06-971Z] Change outputs-reexport-verified-bom (2026-11-06). export_outputs re-ran from the current commit after a clean pre-export run_drc. All six artifacts succeeded: gerbers + gbrjob, drill, outline.dxf, board.step, board.svg, schematic.svg. The export_svg sch and pcb renders were regenerated. The silkscreen gerbers now carry the moved FB1 Reference label. outputs/BOM.csv was regenerated from the datasheet-verified docs/BOM.md: every UNVERIFIED note is replaced by the verified figure and its datasheet citation, the LCSC column stays last, and the DNP and no-part rows stay at Qty 0 with an empty LCSC cell. outputs/jlcpcb-bom.csv was left exactly as copperhead export bom wrote it. outputs/README.md now records: KiCad DRC with zone refill and schematic parity at all severities reports 0 violations, 0 unconnected and 0 parity issues (person-reported for the current commit; this run's run_drc agrees but does not run parity); FB1 silk and UNVERIFIED items closed; remaining pre-order checks are 2 oz copper on the JLC form, through-hole J1/J2, finished hole ≥ 1.3 mm for the square J1/J2 pins, FB1/C5 land patterns slightly small (accepted rev A), and the CPL from /release-board. No board, schematic, net, value or footprint change. | why: The previous package predated the BOM datasheet verification and the FB1 label move, so its silkscreen gerber and BOM.csv were stale. Re-exporting from the DRC-clean current commit makes the fab package match the design. The parity result is attributed to the person's KiCad run because copperhead run_drc cannot run parity. | affects: outputs/gerbers/*, outputs/*.drl, outputs/outline.dxf, outputs/board.step, outputs/board.svg, outputs/schematic.svg, outputs/BOM.csv, outputs/README.md, .copperhead/renders/, outputs/jlcpcb-bom.csv (untouched), FB1 silkscreen, J1, J2, C5, assembly.qty, pcb.copper_oz, docs/CHANGELOG.md
- 2026-11-06 [run 2026-11-06T06-27-28-454Z] Change fix-3d-models-u1-l1-f1 (2026-11-06). Only the (model …) path strings of three footprints in the root .kicad_pcb changed. Offset (0 0 0), scale (1 1 1) and rotate (0 0 0) were already set and are unchanged. U1 now points to ${KICAD10_3DMODEL_DIR}/Package_SO.3dshapes/TI_SO-PowerPAD-8.step; the old HTSOP-8-1EP_3.9x4.9mm_Pitch1.27mm.step path did not exist. L1 now uses ${KIPRJMOD}/lib/3d/l1/easyeda_l1.3dshapes/IND-SMD_L12.8-W13.5-H6.5.step (EasyEDA/LCSC C189912) instead of the stock 4.8 mm SRP1245A body. F1 now uses ${KIPRJMOD}/lib/3d/f1/easyeda_f1.3dshapes/FUSE-SMD_L9.7-W5.0-H3.8.step (EasyEDA/LCSC C206915). Alignment at offset 0 / rotation 0 is as the person checked with kicad-cli pcb render and as lib/3d/README.md records; this run did not re-render. The frozen copy in releases/rev-a/design/ was not edited. The L1 community model is 6.5 mm tall against the 6.2 mm datasheet height, so the datasheet stays the reference for enclosure clearance. No pad, net, copper, zone, position or schematic change. DRC clean (no lib_footprint_mismatch), ERC clean, drift clean. | why: The STEP export and renders had a missing U1 body and an under-height L1. Fixing only the model paths repairs the visual and STEP output without touching copper, so every electrical, thermal and clearance constraint is unaffected. The rev A release snapshot stays as it was released. | affects: U1, L1, F1 3D models; tps5430-12-v-to-5-v-industrial-buck-converter.kicad_pcb; outputs/board.step (stale until re-export); docs/BOM.md L1 row; docs/LAYOUT.md item 10; docs/CHANGELOG.md; lib/3d/README.md (unchanged)
- 2026-11-06 [run 2026-11-06T06-29-45-803Z] Change dnp-exclude-from-pos (2026-11-06). Added exclude_from_pos_files to the (attr ...) of the rev A DNP footprints. C7, C8 and C9 now read (attr smd exclude_from_pos_files) and J3 reads (attr through_hole exclude_from_pos_files). Each edit was anchored on that footprint's own path UUID: J3 /713ddfd0-…, C9 /2024000f-…, C7 /42af8bc0-…, C8 /f91725ce-…. exclude_from_bom is deliberately left unset, so the footprints match the drafted schematic symbols (always in_bom yes) and KiCad schematic parity stays clean. The parts stay out of the JLCPCB assembly BOM because it is generated from docs/BOM.md, where they have no LCSC number. No pad, net, copper, zone, position or schematic change. DRC, ERC and drift are clean. If any of these parts is fitted in a later revision, remove exclude_from_pos_files from that footprint. | why: Design review finding assembly-parity.dnp-placed: kicad-cli pcb export pos listed the DNP parts, so an assembler could place parts that rev A intends to leave empty. C7 and C8 are bridged by FB1, and C9 and J3 are optional EN parts (assembly.qty). This is the same pattern already used for TP1–TP7: excluded from the CPL, kept in the KiCad BOM for parity. | affects: C7, C8, C9, J3 footprints; tps5430-12-v-to-5-v-industrial-buck-converter.kicad_pcb; /release-board CPL; copperhead export bom (unchanged); docs/BOM.md; docs/LAYOUT.md; docs/CHANGELOG.md; assembly.qty
- 2026-11-06 [run 2026-11-06T06-32-07-770Z] Change vias-out-of-paste-c3-d1 (2026-11-06). The GND via in C3 pad 2 moved from (132.075, 125.9) to (131.45, 125.3), joined by a 0.3 mm F.Cu stub; its 0.5 mm B.Cu link to U1 pad 9 copper was re-anchored on it. The two D1 pad 2 GND vias moved from (136.5/137.5, 108.6) to (136.5/137.5, 110.0), joined by 1.0 mm F.Cu stubs, with the 1.0 mm B.Cu strap kept. C3 pad 2 gets a pad-level (zone_connect 2) solid override to clear the starved_thermal error that appeared once the in-pad via was gone. The board-wide spoke minimum is unchanged. Zone fills were not edited. DRC, ERC and drift are clean, with 0 unconnected. | why: Design review finding layout-lint.via-in-paste: unfilled vias in a paste opening wick solder and starve the joint. C3.2 is boxed in by SW, VIN_BUCK and C1, so the upper-left corner is the only site with at least 0.2 mm clearance (pcb.min_clearance_mm). The B.Cu path to the U1 exposed-pad copper is kept (thermal.tj_max_C), and the TVS surge return to the B.Cu pour is kept through 1.0 mm stubs. The single-pad solid override is the same narrow fix already used on R1 pad 2. | affects: C3 pad 2, D1 pad 2, R1.2 GND path, GND vias c0ffee00-…-22/-29/-2a, B.Cu links c0ffee00-…-23/-2c, tps5430-12-v-to-5-v-industrial-buck-converter.kicad_pcb, docs/LAYOUT.md, docs/CHANGELOG.md, outputs/ (stale until re-export)
- 2026-11-06 [run 2026-11-06T06-38-16-985Z] Change tent-gnd-vias-c3-d1 (2026-11-06). The three GND vias moved out of paste openings in commit b9fab6c are now tented on both F.Mask and B.Mask, using each via's own tenting property. These are C3.2 via c0ffee00-0009-4000-8000-000000000022 at (131.45, 125.3) and D1.2 vias -29 and -2a at (136.5, 110.0) and (137.5, 110.0). In the KiCad 10 board format that property is the IPC-4761 `(covering (front yes) (back yes))` block, which replaces `(front no) (back no)`. Plugging, filling and capping stay `no`. No position, size, drill, layer, net, track, zone or zone-fill change. No other via changed, and the frozen releases/rev-a/design/ copy was not edited. DRC is clean with 0 unconnected; ERC and drift are clean. | why: The C3 via edge is about 0.01 mm from the pad corner and the D1 vias are 0.2 mm from the pad edge, so no solder-mask web separates them from the joints. An open barrel there can still wick solder, which is the defect vias-out-of-paste-c3-d1 set out to fix (layout-lint.via-in-paste). Tenting closes that path with no copper change, so pcb.min_clearance_mm, thermal.tj_max_C and the TVS surge return are unaffected. Plugging or filling would add fab cost for no further gain at these sizes. | affects: C3 pad 2, D1 pad 2, GND vias c0ffee00-…-22/-29/-2a, F.Mask, B.Mask, tps5430-12-v-to-5-v-industrial-buck-converter.kicad_pcb, docs/LAYOUT.md GND links, docs/CHANGELOG.md, outputs/ mask gerbers (stale until re-export)
- 2026-11-06 [run 2026-11-06T06-38-16-985Z] Correction to the earlier tent-gnd-vias-c3-d1 entry from this run, which it supersedes. The three GND vias c0ffee00-0009-4000-8000-000000000022 (131.45, 125.3), -29 (136.5, 110.0) and -2a (137.5, 110.0) are tented with an explicit per-via `(tenting (front yes) (back yes))` token. That token is the via's own solder-mask tenting property in the KiCad 10 format; it sits beside the board `(setup)` tenting default. The first edit in this run set the IPC-4761 `(covering (front yes) (back yes))` block instead. That was wrong: `covering` is a separate IPC-4761 Type II cover process, not solder-mask tenting, and specifying it can add fab cost. It is reverted to `(covering (front no) (back no))` on all three vias. `plugging`, `capping` and `filling` stay `no`. Finding: before this change the three vias had no per-via `tenting` token. They inherited the board default `(tenting (front yes) (back yes))` at setup line 74, so they were probably already tented. The request's premise that they were open was likely not true for the board file. The explicit token removes the dependence on the global default. No position, size, drill, layer, net, track, zone or zone-fill change. DRC is clean after the correction. | why: Solder-mask tenting is what stops an open barrel from wicking solder at the C3.2 and D1.2 joints, given the 0.01 mm and 0.2 mm via-to-pad gaps. The per-via `tenting` token is the property that controls it. Leaving `covering` set would have asked the fab for an unneeded Type II process. Pinning tenting per via keeps these three vias tented even if someone later changes the board default to untented. | affects: GND vias c0ffee00-…-22/-29/-2a, C3 pad 2, D1 pad 2, F.Mask, B.Mask, board (setup) tenting default (unchanged), tps5430-12-v-to-5-v-industrial-buck-converter.kicad_pcb, docs/LAYOUT.md, docs/CHANGELOG.md, earlier DECISIONS entry of this run (superseded)
- 2026-11-06 [run 2026-11-06T06-47-21-696Z] Change tp4-gnd-trace-straighten (2026-11-06). TP4 (TestPoint_Pad_D1.5mm, uuid 30204844-…) moved with move_footprint from (147.5, 110) to (147.5, 109.08), rotation 0 unchanged. GND segment c0ffee00-0009-4000-8000-000000000027 now runs horizontally from (147.5, 109.08) to J2 pin 2 at (154, 109.08); width 0.5 mm, F.Cu, net GND unchanged. TP4's F.SilkS Reference offset is now (-2.4, 0, 0), left of the pad, at about board x 144.0–146.2, y 108.6–109.6: clear of FB1 pad 2 (right edge ≈ 143.5), TP4's silk circle (left edge ≈ 146.5), J2's '-GND' label at (146, 107) and the new trace, which runs east of the pad. Note: that offset was set by move_footprint itself, which did not report it; I had planned (-2.5, 0) and kept the tool's value because it meets every clearance. TP4's Value and ${REFERENCE} texts are on F.Fab and were left unchanged. J2's text, every other footprint, track, via and zone, and the zone fills are unchanged. The frozen releases/rev-a/ copy was not edited. DRC clean (0 violations, 0 unconnected, no silkscreen findings), ERC clean, drift clean. | why: The ~8° lean on a short GND stub looked like a routing error. Moving the test pad 0.92 mm, rather than adding a bend, gives a straight trace with no extra copper, and moves TP4 further from the 2 mm +5V trace at y 113.4. The default Reference position would have overlapped J2's polarity label, which must stay readable (SPEC §6). Copper is otherwise untouched, so pcb.min_clearance_mm and all electrical constraints are unaffected. | affects: TP4 footprint and Reference silkscreen, GND segment c0ffee00-…-27, J2 pin 2, tps5430-12-v-to-5-v-industrial-buck-converter.kicad_pcb, docs/LAYOUT.md (TP4 placement row, GND links TP4 bullet), docs/CHANGELOG.md, outputs/ (stale until re-export), GND zones (refill with KiCad)
- 2026-11-06 [run 2026-11-06T06-44-46-097Z] Change fit-c9-en-filter (2026-11-06). C9 changes from DNP to fitted 1 nF Samsung CL10B102KB8NNNC (±10 %, 50 V, X7R, 0603), LCSC C1588 (research/parts/jlcpcb-sourcing.md). Its figures are UNVERIFIED until the Samsung datasheet is checked in research/parts/datasheet-verification.md. The schematic value was set through schematic.intent.json and a re-draft; nets are unchanged (C9.1 EN, C9.2 GND). On the board, C9 `(attr smd exclude_from_pos_files)` becomes `(attr smd)`, anchored on path /2024000f-…, so it is placed and appears in the CPL. Its Value text reads 1nF. Footprint, position (131, 132.5), pads and copper are unchanged. This supersedes the parts of earlier entries that call C9 DNP: architecture-subsystems (optional DNP 1 nF EN footprint), part-selection-bom, outputs-package-stage6 (C9 at Qty 0) and dnp-exclude-from-pos (C9 excluded from pos). C7, C8 and J3 stay DNP with exclude_from_pos_files. Outside the C9 scope, and needed for clean DRC: the TP4 Reference property `(at …)` moved from local (0, −1.648) to (−2.4, 0) to clear a silk_overlap with J2's `-GND` text at (146, 107). That is a text-only change with no pad, copper or position change. The frozen releases/rev-a/ copy was not edited. ERC, DRC and drift are clean; legibility shows 0 errors. | why: docs/BRIEF.md Assumptions (decided 2026-11-06, design review P.F3/S.F1) requires C9. ENA is held high only by the TPS5430 internal 1.5 MΩ pull-up and is wired off-board through J3, so noise could turn the converter off. A capacitor to GND cannot raise EN (protection.ena_pin_max_V) and is not the resistor to GND the datasheet forbids. X7R leakage is nA, so power.iin_shutdown_mA still holds at ≈ 0.121 mA. 50 V meets components.voltage_derating and 0603 meets assembly.qty. The added enable delay is ≈ 1.5 ms, which is harmless. The TP4 label move is the narrowest fix that gets DRC to the clean result the request requires. | affects: C9, EN, GND, U1 ENA, TP4 Reference silk, schematic.intent.json, tps5430-12-v-to-5-v-industrial-buck-converter.kicad_sch, tps5430-12-v-to-5-v-industrial-buck-converter.kicad_pcb, docs/BOM.md, docs/SUBSYSTEMS.md §5, docs/PINOUT.md, docs/LAYOUT.md, docs/DEVPLAN.md §3, docs/CHANGELOG.md, outputs/ (stale until re-export), earlier DECISIONS entries naming C9 DNP (superseded)
- 2026-11-06 [run 2026-11-06T06-53-05-972Z] Change reapply-c9-fitted-board (2026-11-06). The board half of change fit-c9-en-filter (commit 59a5f79) was lost when the concurrent run tp4-gnd-trace-straighten (commit 708b948) rewrote the .kicad_pcb from its own copy. This run re-applies it on the C9 footprint only (path /2024000f-9ed6-5dea-8bf3-77783667258d). The Value property changes from 'DNP' to '1nF' (uuid d65a621d-…, same position, F.Fab layer and effects). (attr smd exclude_from_pos_files) changes to (attr smd), so C9 is placed and appears in the CPL. Footprint, position (131, 132.5), rotation, pads, nets (C9.1 EN, C9.2 GND), copper and text positions are unchanged. TP4 was checked and left as committed in 708b948: at (147.5, 109.08), Reference at local (-2.4, 0). No other footprint, track, via, zone or zone-fill change. The schematic and docs (BOM, SUBSYSTEMS, PINOUT, LAYOUT, DEVPLAN) already showed C9 fitted and were not edited. DRC, ERC and drift are clean. The frozen releases/rev-a/ copy was not edited. | why: Without this, the board disagreed with the schematic and BOM: C9 would have been left out of the pick-and-place file (assembly.qty) and would fail KiCad schematic parity on Value. This is a straight re-apply of an already-reviewed change, so protection.ena_pin_max_V (a capacitor cannot pull EN high) and power.iin_shutdown_mA (nA X7R leakage, about 0.121 mA total) stay as recorded in fit-c9-en-filter. Process note: two copperhead runs editing the .kicad_pcb at the same time can overwrite each other, so board-editing runs should be serialised. | why: Restores the board to match the committed schematic and BOM for C9 after a concurrent run overwrote the board file. Only the two lost tokens are re-applied, so no other copper or placement changes. | affects: C9 footprint (Value, attr), EN, tps5430-12-v-to-5-v-industrial-buck-converter.kicad_pcb, /release-board CPL, KiCad schematic parity, assembly.qty, docs/CHANGELOG.md, earlier entries fit-c9-en-filter and tp4-gnd-trace-straighten
- 2026-11-06 [run 2026-11-06T07-40-57-849Z] Change gnd-stitching-vias-density (2026-11-06). Added 41 GND vias and 5 short GND F.Cu stubs to the .kicad_pcb. Each via is 0.6 mm pad, 0.3 mm drill, F.Cu–B.Cu, net GND, with an explicit (tenting (front yes) (back yes)) like tent-gnd-vias-c3-d1 (commit eacf079); covering, plugging, capping and filling stay no. Via uuids use prefix 5717c400-000d, stub uuids 5717c400-000e. (a) Return vias, each within about 1 mm of the pad edge on the side away from the pad's other terminal: C1.2 (132, 131.55), in the F.Cu pour; C2.2 (136.55, 118.95) at the south-east corner with a 0.5 mm stub from (135.8, 118.3), because the B.Cu +5V Kelvin feed (y 116.8) and R4 feed (y 115.9) block the east-side middle; C5.2/C6.2 a strap via at (150.975, 116.8) on a 0.5 mm F.Cu strap between the two GND pads, plus (152.3, 115.65) and (153.4, 115.65) above C6.2; D3.2 (135.2, 134.75) and (137.6, 134.75), each with a 0.5 mm stub. (b) 34 interior vias on a roughly 5 mm grid where both GND pours are present, including (140.5, 112.5) and (142.5, 135.5), which were added after the first DRC to close gaps of about 4.2 and 4.7 mm. Sites are listed in docs/LAYOUT.md. (c) No via is inside a pad or paste opening, inside SW_copper_F.Cu or SW_copper_B.Cu, or inside the H1/H2 keepouts. DRC is clean with 0 unconnected; ERC is clean. (d) The 1 mm edge-to-edge spacing from FB, EN and the R2.1 Kelvin feed and the ~4 mm coverage target were checked by hand from the board copper, not by a tool. The tightest spacings are about 1.1 mm (C1.2 via to the C9.1 EN pad) and about 1.15 mm ((114.2, 133.4) to the EN trace at y 135). Coverage excludes the U1/SW area, where the B.Cu SW zone displaces the GND pour. No footprint, track, existing via, zone or zone fill changed; the frozen releases/rev-a/ copy was not edited. | why: The F.Cu GND pour is cut up by the power traces, so the C1, C2, C5, C6 and D3 ground returns ran 1.9–4.6 mm through narrow F.Cu necks before reaching the solid B.Cu pour, and interior pour areas were up to 12.5 mm from any GND via. Short vias at each return and a ~5 mm interior grid tie the two pours together where the current flows (thermal.component_rise_C, thermal.tj_max_C, pcb.copper_oz, docs/BRIEF.md Physical). Tenting matches the existing practice, so no open barrel can wick solder. The 1 mm margin keeps GND vias from adding coupling to the FB divider and Kelvin feed (power.vout_V) and the EN line (protection.ena_pin_max_V). Nothing else on the board moves, so every other constraint is unaffected. | affects: GND net, C1.2, C2.2, C5.2, C6.2, D3.2, GND_pour_F.Cu, GND_pour_B.Cu (refill pending), SW_copper zones (avoided), H1/H2 keepouts (avoided), FB, EN, R2.1 Kelvin feed (1 mm margin), tps5430-12-v-to-5-v-industrial-buck-converter.kicad_pcb, docs/LAYOUT.md, docs/CHANGELOG.md, outputs/ (stale until re-export)
- 2026-11-06 [run 2026-11-06T09-25-26-289Z] Change c3-via-bcu-link-straighten (2026-11-06). In the .kicad_pcb, only the end point of the 0.5 mm B.Cu GND segment c0ffee00-0009-4000-8000-000000000023 changed, from (127.2, 125.9) to (127.2, 125.3). The segment now runs horizontally at y 125.3 from the C3.2 GND via at (131.45, 125.3) into U1 pad 9's B.Cu copper. The start, width (0.5 mm), layer (B.Cu), net (GND) and uuid are unchanged. The new end is still inside pad 9's 2.95 × 4.5 mm B.Cu copper centred at (126, 126.5), about x 124.5–127.5 and y 124.25–128.75, so the C3.2 to exposed-pad GND path is the same. No footprint, via, other track, zone or zone-fill change. No schematic or net change. The frozen releases/rev-a/ copy was not edited. DRC clean (0 violations, 0 unconnected), ERC clean, drift clean. | why: The ~8° lean was left over from change vias-out-of-paste-c3-d1 (commit b9fab6c), which moved the via from (132.075, 125.9) to (131.45, 125.3) but not the U1 end, so it read as a routing error. Moving only the end that lands inside the pad copper straightens it with no change in connectivity. The pad-9 return stays (thermal.tj_max_C), and DRC confirms clearance to other B.Cu nets (pcb.min_clearance_mm). GND on the GND pour does not conflict with the existing B.Cu fill. | affects: GND segment c0ffee00-0009-4000-8000-000000000023, C3 pad 2 GND via c0ffee00-0009-4000-8000-000000000022 (unchanged), U1 pad 9 B.Cu copper, tps5430-12-v-to-5-v-industrial-buck-converter.kicad_pcb, docs/LAYOUT.md (GND links C3.2 bullet), docs/CHANGELOG.md, outputs/ (B.Cu gerber stale until re-export), GND_pour_B.Cu (refill with KiCad)
- 2026-11-06 [run 2026-11-06T09-29-56-404Z] Change docs-sync-board-9af7427 (2026-11-06), docs only. docs/LAYOUT.md, DECISIONS and CHANGELOG now match board commit 9af7427. The person made that commit with a KiCad pcbnew script, outside copperhead do, at their own request. Coordinates come from the live .kicad_pcb. The change list comes from the person's summary of the commit, because the workspace is not a git repository and the commit message could not be read in this run. The commit made three changes. (1) Trace tidy-up, geometry only, with no net, width class, footprint or pad change: R1.2 now runs into the D1.2 GND via at (136.5, 110); SW leaves U1.8 horizontally and turns 45° into the y 124 run; FB runs along the y 128.2 channel with a 45° into R3.1 and a tee from R2.2; the C1.2 to D3.2 return is a 45° plus a horizontal; a 1.0 mm F.Cu strap joins the D3 vias at y 135.5; VIN_RAW enters F1.1 at a true 45°; the C2.2 and C3.2 via stubs run at 45°; VIN_BUCK and LED_A are orthogonal; and 14 corners are mitred. (2) TP7 moved from (104, 132.5) to (120, 135), on the EN trace 4 mm west of J3.1, which removes the 20 mm EN run to the left edge. EN still has no pull-up. (3) The 34 ad hoc interior GND vias of gnd-stitching-vias-density were replaced by 59 tented vias (0.6/0.3 mm) on a lattice aligned with the edge fence: 27 on 5 mm nodes, 20 on 2.5 mm nodes and 12 on 1.25 mm nodes. The seven pad-return vias (5717c400-000d) with their stubs, and the 34 edge-fence and power-stage vias (5717c400-000b), are unchanged. Person-reported: the largest distance to a GND via is 4.5 mm inside both pours; zones were refilled with KiCad; and KiCad DRC with schematic parity, copperhead check and copperhead sync --dry-run were all clean at 9af7427. outputs/ stays stale until the next export. No .kicad_pcb, .kicad_sch or schematic.intent.json edit in this run. | why: copperhead do cannot refill zones. When copper moves inside a GND pour, its DRC fails on the stale fill, and an empty fill fails the unrouted check. So a tidy-up and via re-gridding inside the pours could only be made and verified with KiCad's own filler, and the person chose to do it in pcbnew. Recording it here keeps the design memory in step with the copper. The shorter EN route takes ~20 mm of high-impedance EN trace (1.5 MΩ internal pull-up) off the GND pour, which helps the noise concern that C9 addresses. Nothing moves closer to the EN or FB copper (the nearest lattice via to TP7, at (120, 132.5), is ~1.45 mm edge to edge). protection.ena_pin_max_V, power.vout_V, thermal.tj_max_C and pcb.min_clearance_mm are therefore unaffected. | affects: TP7, EN, FB, SW, VIN_RAW, VIN_BUCK, LED_A, GND (R1.2, C1.2–D3.2, D3 via strap, C2.2/C3.2 stubs, 59 lattice vias), GND_pour_F.Cu, GND_pour_B.Cu (refilled in KiCad), tps5430-12-v-to-5-v-industrial-buck-converter.kicad_pcb (commit 9af7427, not edited here), docs/LAYOUT.md (placement table, Fine list, Routed, GND links, stitching section), docs/CHANGELOG.md, outputs/ (stale until re-export), earlier DECISIONS entry gnd-stitching-vias-density (interior grid superseded)
- 2026-11-06 [run 2026-11-06T10-59-29-085Z] Change review-docs-fab-notes (2026-11-06), design review L.F2. A fabrication note is added to the .kicad_pcb as one gr_text on Cmts.User (User.Comments) at (100, 143), below the Edge.Cuts outline (uuid fab0e0e0-0001-4000-8000-000000000001). It states: (1) J1 and J2 plated holes finish at 1.3 mm minimum for the 0.9 mm square terminal pins; (2) outer copper is 2 oz (70 µm) on F.Cu and B.Cu; (3) vias marked tented must be tented on both sides. outputs/README.md gets a matching 'Fabrication notes' section. No copper, mask, silk, footprint, track, via, zone or zone-fill change. DRC clean. The exported gerbers predate the note, but User.Comments is not a fab layer, so they stay valid for fabrication. | why: The finished-hole requirement (research/parts/datasheet-verification.md, Phoenix 12/21/2021: a 0.9 mm square pin has a ≈ 1.27 mm diagonal), the 2 oz stackup (pcb.copper_oz) and the per-via tenting (tent-gnd-vias-c3-d1, gnd-stitching-vias-density) are only met if the fab is told. Putting the note in the board file means it travels with the design, and putting it in the README means it reaches the order form. A comment layer adds nothing to copper, so pcb.min_clearance_mm and every electrical constraint are untouched. | affects: J1, J2, all tented GND vias, Cmts.User layer, tps5430-12-v-to-5-v-industrial-buck-converter.kicad_pcb, outputs/README.md, docs/LAYOUT.md, docs/SPEC.md §5, docs/SUBSYSTEMS.md §4, pcb.copper_oz, connector.current_A
- 2026-11-06 [run 2026-11-06T10-59-29-085Z] Change review-docs-fab-notes (2026-11-06), design review R.F1 and P.F2, ACCEPTED FOR REV A with no copper change. C3 (100 nF HF bypass) returns to GND through its via at (131.45, 125.3) and the 0.5 mm B.Cu link to U1's exposed-pad copper, because the F.Cu channel between the VIN_BUCK copper and the D3 SW pad is only 0.65 mm. C1 (10 µF) closes the primary input loop: pad 1 is about 1.6 mm from U1 pin 7, and a 1.5 mm F.Cu GND run goes to the D3 anode. C2 sits about 12 mm from U1 on the VIN_BUCK trunk and is bulk input capacitance only. docs/SUBSYSTEMS.md §3 and the docs/BOM.md C2 row no longer claim C1 and C2 share the ≈ 1.5 A RMS ripple equally. Rev B candidate: move D3 or C1 to open the F.Cu channel. Recorded in docs/LAYOUT.md Draft quality. | why: Widening the channel means moving D3 or C1 inside the tight hot loop and re-routing SW, VIN_BUCK and the GND returns, followed by a KiCad refill. That is too much rework for a documented, bench-checkable compromise on a 5–10 board prototype. C1 alone stays inside its Murata thermal curve at ≈ 1.5 A RMS (about 3–4 °C at 2 A RMS). The real risk is HF ringing at SW, which DEVPLAN T5 checks. | affects: C1, C2, C3, D3, U1 pad 9, VIN_BUCK, SW, GND, docs/LAYOUT.md Draft quality, docs/SUBSYSTEMS.md §3, docs/BOM.md C2 row, thermal.component_rise_C, power.vout_ripple_mVpp
- 2026-11-06 [run 2026-11-06T10-59-29-085Z] Change review-docs-fab-notes (2026-11-06), design review P.F1, B.F1 and B.F3. (a) Inductor-peak criterion corrected in SPEC §2, SUBSYSTEMS §3, the BOM L1 row and the power.inductor_peak_A constraint. The ≈ 3.25 A peak at 3 A out must stay BELOW the TPS5430 4.0 A minimum current limit (VERIFIED), and L1 Isat 12.5 A (VERIFIED) must EXCEED the 6.0 A maximum current limit. Both hold. The 6.0 A maximum is the review's figure and is not yet in research/parts/datasheet-verification.md, so it is flagged 'confirm on the datasheet'. (b) Vout tolerance stack redone in SPEC §2/§3, SUBSYSTEMS §4/§9 and power.vout_V, using datasheet Vref 1.196–1.245 V over temperature and the fitted 0.1 % R2/R3 (ratio 4.0802–4.0926). Result: ≈ 4.880–5.095 V, which MEETS the ±3 % budget (4.85–5.15 V) with ≈ 30 mV margin low and ≈ 55 mV high. With 1 % parts it would be ≈ 4.814–5.165 V and fail on both sides. An earlier draft line in this run said 4.833–5.149 V; that was corrected before verification. (c) Pre-verification figures replaced with the BOM-corrected, datasheet-cited values in SPEC (fuse rerating, ENA 7 V, D2 Vz 11.4–12.7 V, J1/J2, §9 Q1 closed) and SUBSYSTEMS (§0/§1 D2 Vz and Q1 RDS(on)/IDM, J1/J2, ENA, C5 ESR, D4 VF). In DECISIONS.md, three past entries (ENA ~7 V, L1 12.5 × 12.5 mm, 'at or below 12 V') get bracketed corrections; no history is deleted. No value, part, net or copper change. | why: The backwards criterion would have let a reviewer accept an inductor that saturates in current limit, and the tolerance stack must use the datasheet reference range rather than an assumed ±1.5 % to prove power.vout_V. Fixing the text costs nothing, and none of the corrected figures breaks a budget. The low-side Vout margin is only ≈ 30 mV, so DEVPLAN T3 at 50 °C is the confirming test. | affects: L1, U1, R2, R3, D2, Q1, F1, J1, J2, C5, D4, power.inductor_peak_A, power.vout_V, docs/SPEC.md §2/§3/§5/§9, docs/SUBSYSTEMS.md §0/§1/§3/§4/§5/§6/§9, docs/BOM.md L1 row, docs/DECISIONS.md (annotated past entries)
- 2026-11-06 [run 2026-11-06T11-06-16-171Z] Change docs-clear-c9-u1-ilim-marks (2026-11-06), docs only. Two open marks are now settled by research/parts/datasheet-verification.md (AGENTS.md rule 5). (1) C9 CL10B102KB8NNNC: the UNVERIFIED sentence in the docs/BOM.md C9 row is replaced by a VERIFIED citation (research/parts/datasheet-verification.md C9 row, commit fc60842; Samsung Electro-Mechanics product page and spec sheet for CL10B102KB8NNN, generated 2026-11-06, p. 1): 1.0 nF, ±10 %, 50 V DC, X7R (−55 to +125 °C), 0603 (1.60 × 0.80 × 0.80 mm), mass production; the trailing C is the packaging code. X7R leakage is worded as a typical-behaviour estimate (nA class), not a verified datasheet figure, in both the C9 row and the shutdown roll-up line. (2) TPS5430 current limit: IHS(OC) 4.0 / 5.0 / 6.0 A min / typ / max (TI SLVS632L rev L, p. 5; commit b70d55a) is now cited in the docs/BOM.md U1 and L1 rows, docs/SPEC.md §2 inductor-peak row, docs/SUBSYSTEMS.md §3 U1 and L1 bullets, and constraint power.inductor_peak_A, replacing every 'confirm on the datasheet' / 'not yet listed' clause. No value, part, net, footprint, budget, schematic, board or outputs/ change. Past CHANGELOG and DECISIONS entries and the DEVPLAN §2 historical table keep their original wording. BOM cells hold no pipe characters; Refdes, Value, Footprint stay first and LCSC last. Drift clean. | why: copperhead export bom leaves UNVERIFIED rows out of outputs/jlcpcb-bom.csv, so without this C9 (the fitted EN noise filter) would not be assembled. The 6.0 A citation closes the last open item behind the L1 Isat criterion; L1 Isat 12.5 A > 6.0 A and the 3.25 A peak < 4.0 A both still hold, so power.inductor_peak_A, protection.ena_pin_max_V and power.iin_shutdown_mA (≈ 0.121 mA) are unchanged. Leakage is not on the Samsung spec sheet, so calling it verified would overstate the evidence. | affects: C9, U1, L1, docs/BOM.md (U1, L1, C9 rows; shutdown roll-up), docs/SPEC.md §2, docs/SUBSYSTEMS.md §3, .copperhead/constraints.json power.inductor_peak_A, outputs/jlcpcb-bom.csv (re-export with copperhead export bom to pick up C9), docs/CHANGELOG.md
- 2026-11-06 [run 2026-11-06T11-09-58-771Z] Change outputs-reexport-post-9af7427 (2026-11-06). Pre-export run_drc was clean. export_outputs then re-ran from the current tree (after c4297c8, KiCad zone refill, per the person; the workspace is not a git repository, so the hash could not be read). All six artifacts succeeded: gerbers with gbrjob, Excellon drill, outline.dxf, board.step, board.svg, schematic.svg. export_svg sch and pcb renders were regenerated in .copperhead/renders/. The package now carries every board change since the 2873a78 export: TP4 move (708b948), C9 fitted (833bb5d), the 59-via GND lattice, trace tidy-up and TP7 at (120, 135) (9af7427), the straightened C3 B.Cu link (5d7e534), the User.Comments fab note (4a9f21c) and the KiCad refill (c4297c8). In outputs/BOM.csv the C9 row is now fitted: CL10B102KB8NNNC, Qty 1, 1nF, LCSC C1588, VERIFIED against the Samsung spec sheet. That gives 22 fitted placements; C7, C8, J3, TP1–TP7, H1 and H2 stay at Qty 0 with an empty LCSC cell. outputs/jlcpcb-bom.csv was left exactly as copperhead export bom wrote it (commit 64a6da4, includes C9). PNG top/bottom renders were NOT produced: no copperhead tool available to this run writes PNGs (export_svg writes SVG only, export_outputs makes no PNG), so outputs/renders/ was not created, and the README says so. outputs/README.md records: the regenerated artifacts and source commit; KiCad DRC with zone refill and schematic parity at 0 violations, 0 unconnected, 0 parity issues (person-reported); all BOM figures datasheet-verified; and six pre-order checks: 2 oz on the JLC form, through-hole J1/J2, finished hole ≥ 1.3 mm for the J1/J2 square pins (also in the fab note), tented vias kept tented, FB1/C5 lands slightly small (accepted for rev A), and the CPL from /release-board. It also states that these changes postdate the frozen releases/rev-a/ release, so this package belongs to the next revision. No board, schematic, intent, net, value or footprint change; releases/rev-a/ not edited. | why: The previous package predated six board commits, so its copper, drill, mask and silk files and its BOM.csv (C9 still DNP) no longer matched the design. Re-exporting from the DRC-clean, KiCad-refilled board makes the fab package match. Marking it as the next revision keeps it from being mistaken for the frozen rev A release. The PNG renders are reported as not produced rather than faked, because no available tool can write them. | affects: outputs/gerbers/*, outputs/*.drl, outputs/outline.dxf, outputs/board.step, outputs/board.svg, outputs/schematic.svg, outputs/BOM.csv (C9 row), outputs/README.md, .copperhead/renders/, outputs/jlcpcb-bom.csv (untouched), outputs/renders/ (not created), C9, assembly.qty, pcb.copper_oz, releases/rev-a/ (untouched), docs/CHANGELOG.md
- 2026-11-06 [run 2026-11-06T14-57-45-784Z] Change docs-sync-board-956cc1e (2026-11-06), docs only. docs/LAYOUT.md, DECISIONS and CHANGELOG now match board commit 956cc1e. The person made that commit with a KiCad pcbnew script and a kicad-cli zone refill, outside copperhead do, at their own request. Coordinates come from the live .kicad_pcb. The change list follows the person's summary, because the workspace is not a git repository and the commit message could not be read here. (1) Placement: R3 (119.5, 129.2) → (119.5, 129.405); TP6 (116.3, 128.2) → (117.0, 129.405); the FB silkscreen gr_text is at (115.2, 129.405). R2 did not move. (2) FB route, 0.25 mm F.Cu: U1.4 (123.3, 128.405) runs straight west at y 128.405 to (119.675, 128.405), takes one 45° into R3.1 at (118.675, 129.405), then runs straight at y 129.405 into TP6. R2.2 tees straight down from (120.325, 127.2) to (120.325, 128.405). This replaces the 9af7427 route along the y 128.2 channel and removes its 0.205 mm jog at U1.4 and its 45° plus stub into TP6. (3) R3 moved with the run: at y 128.405 with R3 left at y 129.2, the R3.2 GND pad (top edge y 128.725) would be 0.195 mm from the track edge (128.53), under the 0.2 mm minimum. At y 129.405 the gap is ≈ 0.40 mm. TP6 sits at x 117.0, not 116.3: its pad left edge (116.5) keeps 1.20 mm edge to edge from the 0.6 mm GND lattice via at (115, 130), meeting the ≥ 1 mm GND-via-to-FB spacing of gnd-stitching-vias-density. At x 116.3 it would be 0.5 mm. Both clearances were re-checked by hand from the pad geometry in this run. Person-reported: KiCad DRC with zone refill and schematic parity, copperhead check and copperhead sync --dry-run were clean at 956cc1e. The commit postdates the rev B release (47b172a), so it belongs to the next revision; outputs/ is stale until the next export. No .kicad_pcb, .kicad_sch, schematic.intent.json, outputs/ or releases/ edit in this run; no net, value, width or footprint change. | why: copperhead do cannot refill zones, so moving FB copper and two footprints inside the GND pours fails its DRC on stale fill; the earlier request fb-route-straighten-r3-tp6 was refused for that reason, and the person made the change in KiCad instead. Recording it keeps the design memory in step with the copper. The straight run shortens the high-impedance FB node and keeps it left of U1, away from SW (power.vout_V). R3 and TP6 were placed so pcb.min_clearance_mm and the 1 mm GND-via-to-FB margin both still hold. | affects: R3, TP6, FB net, R2.2 tee, FB silkscreen label, GND lattice via (115, 130), tps5430-12-v-to-5-v-industrial-buck-converter.kicad_pcb (commit 956cc1e, not edited here), docs/LAYOUT.md (placement table, FB legs bullet, 9af7427 tidy-up FB bullet superseded, new 956cc1e bullet), docs/CHANGELOG.md, outputs/ (stale until re-export), releases/ (rev B 47b172a untouched), pcb.min_clearance_mm, power.vout_V, earlier DECISIONS entry docs-sync-board-9af7427 (FB route superseded)
- 2026-11-06 [run 2026-11-06T15-35-54-832Z] Change docs-sync-board-4698973 (2026-11-06), docs only. docs/LAYOUT.md, docs/SPEC.md §6, mech.board_mm, DECISIONS and CHANGELOG now match board commit 4698973. The person made that commit with a KiCad pcbnew script and a kicad-cli zone refill, outside copperhead do, at their own request. Coordinates are read from the live .kicad_pcb. The change list follows the person's summary, because the workspace is not a git repository and the commit message could not be read here. (1) J1 moved from (106, 115.5) 90° to (105.6, 110.42) 270°: pin 1 VIN_RAW is on top at y 110.42 and pin 2 GND is at y 115.5. J2 moved from (154, 104) 270° to (154.4, 109.08) 90°: pin 2 GND is on top at y 104 and pin 1 +5V is at y 109.08. Horizontal MKDS wire entry is footprint local +y, so it faces −x for J1 and +x for J2, out over each terminal's own edge. The clamp faces (local y 4.72) sit at x ≈ 100.88 and ≈ 159.12, about 0.9 mm inside the edges, so the pin-1 silk triangles stay on the board. (2) TP4 moved from (147.5, 109.08) to (147.3, 101.8). Its 0.5 mm GND trace runs along y 101.8 to (152.2, 101.8) and takes one 45° into J2.2 at (154.4, 104). (3) VIN_RAW (1.5 mm) runs straight from J1.1 to (109.895, 110.42), then one 45° into F1.1 at (114.315, 106). The +5V trunk (2.0 mm) at x 156.8 stops at y 111.48 and takes one 45° into J2.1. (4) Silkscreen: +VIN (114, 110.42); -GND (114, 115.5); J2 -GND (146.6, 104); +5V (147, 109.08). References: TP4 (144.8, 101.8), FB1 (141.8, 101.9) (local (−4.6, 0); the fb1-reference-silk-clear entry's (−4.6, −0.7) is superseded), J1 (112.1, 118.5), J2 (148, 106.54). TP4's own GND name text was removed for lack of room, on purpose; TP4 is identified by its Reference and its trace to J2.2. (5) docs/PINOUT.md is not edited: it gives J1/J2 as pin-to-net only, and those mappings are unchanged. (6) A new openspec requirement in openspec/changes/docs-sync-board-4698973 says each screw terminal's wire openings face outward over its own board edge with nothing in front of the clamps. It cites docs/BRIEF.md Physical and is verified from the footprint rotation and the clamp-face position. Person-reported: KiCad DRC with zone refill and schematic parity, copperhead check and copperhead sync --dry-run were clean at 4698973. The commit postdates rev C (0abd2dd), so it belongs to rev D. outputs/ is stale until the next export. No .kicad_pcb, .kicad_sch, schematic.intent.json, outputs/ or releases/ edit; no net, value, width or footprint change. | why: In rev A to C both terminals faced inward, and J2's wire openings faced C5. A field wire could not be inserted or clamped without fouling the parts in front of it. docs/BRIEF.md Physical (2026-11-06) now requires outward-facing openings. Turning the terminals moves copper and footprints inside the GND pours. copperhead do cannot refill zones, so its DRC would fail on stale fill; the earlier request to turn the terminals was refused for that reason, and the person made the change in KiCad instead. Recording it keeps the design memory in step with the copper. Pin-to-net mapping, trace widths (VIN_RAW 1.5 mm and +5V 2.0 mm, ≥ 4 A and 3 A) and the terminals' ratings are unchanged. protection.fuse_rating_A, power.iout_A and connector.current_A therefore still hold. The outline and the H1/H2 keepouts are unchanged (mech.board_mm). | affects: J1, J2, TP4, VIN_RAW, +5V, GND (TP4 → J2.2), J1/J2/TP4/FB1 silkscreen, tps5430-12-v-to-5-v-industrial-buck-converter.kicad_pcb (commit 4698973, not edited here), docs/LAYOUT.md (placement rows, Routed, GND links, Silkscreen), docs/SPEC.md §6, mech.board_mm, openspec/changes/docs-sync-board-4698973, docs/PINOUT.md (checked, unchanged), docs/CHANGELOG.md, outputs/ (stale until re-export), releases/ (rev C 0abd2dd untouched), earlier DECISIONS entries fb1-reference-silk-clear and tp4-gnd-trace-straighten (positions superseded)
- 2026-11-06 [run 2026-11-06T16-01-19-392Z] Change outputs-reexport-rev-d (2026-11-06). The fabrication package in outputs/ was re-exported at commit 1393414, the rev D release commit (releases/rev-d/, frozen from e03bac1; the board is unchanged since e03bac1; hashes as given by the person). It replaces the be48dd2 export, which predated board commits 956cc1e and 4698973. Pre-export run_drc was clean. export_outputs produced all six artifacts: gerbers with gbrjob, Excellon drill, outline.dxf, board.step, board.svg and schematic.svg. The export_svg sch and pcb renders were regenerated. Before the README was written, this run re-read the board file: J1 (at 105.6 110.42 -90), where −90 = 270°; J2 (at 154.4 109.08 90); TP4 (at 147.3 101.8). It also read the rev D placement file releases/rev-d/fabrication/...-placement.csv: it lists C9 and has no row for C7, C8, J3 or TP1–TP7. outputs/BOM.csv was compared row by row with docs/BOM.md. Every row still matches (22 fitted placements, C9 fitted with LCSC C1588), so the file was left byte-for-byte as it was rather than rewritten with identical content. outputs/jlcpcb-bom.csv was not touched; per the person it was written by copperhead export bom at 1393414 and is byte-identical to releases/rev-d/bom/jlcpcb-bom.csv. outputs/README.md was rewritten for rev D. It names releases/rev-d/ as the set to send to a fab, including its placement file, and outputs/ as the working review copy. It records KiCad DRC with zone refill and schematic parity at 0 violations, 0 unconnected and 0 parity issues at e03bac1 (person-reported). It records terminal orientation as verified from the footprint rotation (re-read here) and from kicad-cli 3D renders (person-reported). It keeps the fab notes: 1.3 mm finished J1/J2 holes, 2 oz on the order form, tented vias. It adds a pre-order check that JLCPCB's placement preview shows J1's openings toward the left edge and J2's toward the right. Stale text was removed: TP4 at (147.5, 109.08), the 'next revision after rev A' framing, and 'workspace is not a git repository'. No .kicad_pcb, .kicad_sch, schematic.intent.json or releases/ edit. | why: The be48dd2 package no longer matched the copper, silk and placement of the released board, because of the FB route and the turned terminals. A stale working package next to a frozen release invites ordering the wrong files. Pointing the order at releases/rev-d/ keeps one authoritative set. Checking the terminal rotation in the placement preview catches an assembler that misrotates J1 or J2, which would put the wire openings back inward and break docs/BRIEF.md Physical (mech.board_mm). Claims about the board and the placement file were checked against the files rather than taken from memory. | affects: outputs/gerbers/*, outputs/*.drl, outputs/outline.dxf, outputs/board.step, outputs/board.svg, outputs/schematic.svg, outputs/README.md, outputs/BOM.csv (verified, unchanged), outputs/jlcpcb-bom.csv (untouched), .copperhead/renders/, releases/rev-d/ (read only), J1, J2, TP4, mech.board_mm, pcb.copper_oz, assembly.qty, docs/CHANGELOG.md
- 2026-11-06 [run 2026-11-06T23-15-06-464Z] Change copperhead-mark-front-silk (2026-11-06). The copperhead mark (brand/mark.svg, scaled to 4.0 mm overall) is drawn as board graphics on F.SilkS with no net: gr_circle centre (104, 136.5) r 0.92 mm, width 0.4 mm, and four 0.4 mm gr_line ticks from 0.92 to 1.80 mm out along ±x and ±y. It sits in the free lower-left corner (no footprint, courtyard or silkscreen in x 101–107, y 133.5–139.5), ink extent x 102.0–106.0, y 134.5–138.5, ≈ 2.05 mm and 1.55 mm inside the left and bottom edges. The person asked for it on 2026-11-06 after rev D was released, so it belongs to rev E; rev D and its public release have no mark. No net, footprint, copper, zone, schematic, BOM, releases/ or outputs/ change. DRC clean with no silk findings, ERC and drift clean. | why: docs/BRIEF.md Physical (2026-11-06) requires the mark on the front silkscreen, about 4 mm across, in a free corner clear of pads, courtyards and other silkscreen. Native board graphics (not a footprint) keep it out of the BOM, CPL and schematic parity, and silkscreen-only geometry leaves every electrical, clearance and keepout constraint untouched (the H1 keepout at (103, 103) is far away; nearby GND vias are tented). | affects: F.SilkS, tps5430-12-v-to-5-v-industrial-buck-converter.kicad_pcb, docs/LAYOUT.md Silkscreen, docs/CHANGELOG.md, openspec/changes/copperhead-mark-front-silk, rev E (rev D release unchanged), outputs/ (stale until next export)
- 2026-11-06 [run 2026-11-06T23-28-16-532Z] Change bom-dnp-no-part-marker (rev E, E11; findings F.F1, G.F1, S.F2 and the rev D sweep assembly-parity items), docs only. In docs/BOM.md the MPN cell of J3, C7 and C8 changes from 'DNP' to '—'. Value (EN, DNP, DNP), footprint, the empty LCSC cell and the not-fitted (DNP in rev A to E) rationale stay. The exporter source is not in the workspace and the literal text '(no part)' appears nowhere in it. So the marker was taken from the existing output: TP1–TP7, H1 and H2 (MPN '—', empty LCSC) are already left out of outputs/jlcpcb-bom.csv, while J3/C7/C8 (MPN 'DNP', empty LCSC) were emitted. The DNP state for J3, C7 and C8 therefore lives in docs/BOM.md (MPN '—', no LCSC) and in the board footprints' exclude_from_pos_files (change dnp-exclude-from-pos). The schematic symbols still read (in_bom yes) (dnp no): the drafting engine always writes those and refuses direct edits, so the schematic DNP attribute waits on the engine. The header sentence on what the generated BOM omits is updated. No .kicad_sch, .kicad_pcb, schematic.intent.json, releases/ or outputs/ edit. outputs/jlcpcb-bom.csv keeps the old J3/C7/C8 lines until the next `copperhead export bom --supplier jlcpcb`. | why: Before this change the assembler's BOM listed J3 as a fitted line with no part number and C7/C8 as a line valued DNP, so unfitted parts could be quoted or placed (assembly.qty). The marker that already keeps the test pads and mounting holes out of the BOM is the narrowest fix with evidence that it works. Keeping exclude_from_bom unset preserves schematic parity. | affects: J3, C7, C8, docs/BOM.md (rows and header), copperhead export bom / outputs/jlcpcb-bom.csv (stale until re-export), assembly.qty, schematic DNP attribute (deferred to the engine), docs/CHANGELOG.md
- 2026-11-06 [run 2026-11-06T23-46-02-525Z] Change rev-e-en-series-bulk-cap-gnd-probe (rev E E6, E7, E10). The schematic now matches board commits 06b32da and 373fb8f, which the person made with a pcbnew script and zone refill. Added to schematic.intent.json and re-drafted: C10 Device:C_Polarized 100uF CP_Elec_8x10 (VIN_BUCK/GND, EEE-FK1H101P, LCSC C178548, not fitted); R5 Device:R 0R 0603 (pin 1 EN_EXT, pin 2 EN; 0603WAF0000T5E, LCSC C21189, UNVERIFIED); TP8 Connector:TestPoint TP_GND3 1.0x1.0 mm (GND). New net EN_EXT = R5.1, J3.1, TP7.1; EN keeps U1.5, C9.1, R5.2. Board edit limited to path/sheetname/sheetfile on the C10, R5 and TP8 footprints (symbol uuids 1166895f-…, 20288dde-…, 2e46c8ff-…). No copper, placement, attribute or silkscreen change. C10 and TP8 carry MPN '—' in docs/BOM.md and exclude_from_pos_files on the board, so they stay out of the assembly BOM and CPL; R5 is fitted. Schematic symbols still read (in_bom yes)(dnp no) because the engine cannot set DNP. KiCad parity and zone-refill DRC were not runnable in this run (copperhead run_drc does not do parity) and must be confirmed by the person with kicad-cli. releases/ and outputs/ untouched. | why: docs/BRIEF.md Parts and Interfaces (amended cd3d0b8) require the bulk capacitor footprint, the 0 Ω EN series position and the GND probe pad beside TP5. The board already had them, so the schematic had to catch up for parity. A 0 Ω series element keeps protection.ena_pin_max_V (no pull-up, no resistor to GND), C10 unfitted leaves power.iin_shutdown_mA unchanged, and C10 at 50 V meets components.voltage_derating. | affects: C10, R5, TP8, J3, TP7, EN, EN_EXT, VIN_BUCK, GND, schematic.intent.json, .kicad_sch, .kicad_pcb (links only), docs/BOM.md, docs/PINOUT.md, docs/SPEC.md, docs/SUBSYSTEMS.md, docs/LAYOUT.md, openspec, protection.ena_pin_max_V, assembly.qty, outputs/ (stale)
- 2026-11-06 [run 2026-11-06T23-54-06-911Z] Rev E E1 (board commit c502f61, made by the person with a pcbnew script and kicad-cli zone refill outside copperhead do): C3 moved from (131.3, 125.9) to (130.55, 126.5) 270° so pad 1 sits on U1.7 and pad 2 joins U1.6 by a 0.6 mm F.Cu run along y 127.135; the C3.2 via at (131.45, 125.3) and its B.Cu link are gone. C1 moved to (131.4, 130.4) and C9 to (131, 133.6) to make room. Postdates rev D (1393414), so rev E; outputs/ stale until the next export. | why: The HF loop was ~64 mm² with a via in series (LR-F1); it is now ~57 mm² all on F.Cu, through pad centres, per TI layout guidance and docs/BRIEF.md Physical (tight switching loop). Resolves the R.F1/P.F2 item accepted for rev A. | affects: C3, C1, C9, U1.6, U1.7, VIN_BUCK, GND, EN, docs/LAYOUT.md, docs/SUBSYSTEMS.md §3
- 2026-11-06 [run 2026-11-06T23-54-06-911Z] Rev E E2 (board commit efb38ed, outside copperhead do at the person's request): SW_copper_F.Cu and SW_copper_B.Cu zones and their four SW vias deleted; SW is only pads and the PH/D3/L1 (and C4/TP5) traces. D3 is cooled from its anode: F.Cu GND pour under the body, GND vias at (135.3, 129.9), (136.4, 129.5), (137.9, 129.5). Rev E; outputs/ stale. | why: SW copper was 102.6 mm² F.Cu + 123.2 mm² B.Cu, a near-field radiator that also displaced the B.Cu ground image under the hot loop (LR-F2, R.Q1); now 47.1 mm² F.Cu, none on B.Cu. B560C RθJT 10 °C/W and RθJA 50 °C/W (Diodes DS13012 rev 19-2, read 2026-11-06) mean heat leaves through both terminals, so the quiet GND anode can sink it. thermal.component_rise_C stays a bench check (T8). | affects: SW, D3, GND pours, thermal.component_rise_C, docs/LAYOUT.md, docs/SPEC.md §4, docs/SUBSYSTEMS.md §3/§9
- 2026-11-06 [run 2026-11-06T23-54-06-911Z] Rev E E3 (board commit efb38ed, outside copperhead do): pad-level solid zone connection (zone_connect 2) on D3.2, C1.2, C2.2, C5.2, C6.2 and D1.2, like C3.2, R1.2 and U1 pad 9; J1.2 and J2.2 keep thermal relief with 1.0 mm spokes (thermal_bridge_width 1). Rev E; outputs/ stale. | why: 0.5 mm spokes added inductance in the commutation loop, thermal resistance from D3 into the pour and impedance in D1's surge return (LR-F3); the terminals keep relief for hand/THT soldering but need wider spokes for 3 A (connector.current_A). | affects: D3, C1, C2, C5, C6, D1, J1, J2, GND, docs/LAYOUT.md
- 2026-11-06 [run 2026-11-06T23-54-06-911Z] Rev E E4 (board commit 6e5b905, outside copperhead do) with E14 silk (06b32da): R4/D4 moved from (112, 131)/(112, 133) to (157.5, 123.5)/(157.5, 127) beside C6, R4 fed on F.Cu from the +5V trunk at (157.5, 118.6); the 44 mm B.Cu LED feed and its vias are gone; the R2.1 Kelvin feed is unchanged. E14: C1, U1, D4, R4 references moved; J1 -GND vertical at (112.4, 115.5). Rev E; outputs/ stale. | why: The LED and Kelvin feeds slotted the B.Cu plane between input and power stage, leaving 1.2 and 2.4 mm ground necks (LR-F4, R.F1); removing the LED feed opens it while the sense point stays at C5 as docs/BRIEF.md Physical requires (power.vout_V). Silk moves fix LR-F5. | affects: R4, D4, /LED_A, +5V, GND_pour_B.Cu, C1/U1/D4/R4/J1 silkscreen, docs/LAYOUT.md
- 2026-11-07 [run 2026-11-07T00-00-05-191Z] Change docs-rev-e-record-corrections (2026-11-07), docs only. (1) The C5 ESR bound is ~40 mΩ (TI SLVS632L rev L eq. 9, ESRmax = 1/(2π·Cout·fco), 220 µF at 18 kHz), replacing ~80 mΩ in SPEC, SUBSYSTEMS, BOM, DEVPLAN and power.output_filter_compensation. The compensation check against eqs. 7–9 gives fco ≈ 16 kHz with 242 µF (3–30 kHz) and an ESR zero ≈ 27 kHz, so the fitted 27 mΩ passes. This closes the compensation half of B.F6. (2) The U1 Tj estimate is ≈ 118 °C at 9 V / 3 A / 50 °C (Ptot ≈ 1.5 W, RDS(on) max 230 mΩ, EVM 45 °C/W), tight by ≈ 7 °C, to be measured in T8 (derate if case > ~100 °C). (3) T10 reverse current is Q1 drain leakage (µA); D2/R1 form no loop; a reading near 0.2 mA means Q1 is conducting or damaged. The IDSS limit is not yet in research/ and must be read from DS37199 before bring-up, so no number was invented. (4) R1 current = D2 current = max(0, Vin − Vz)/100 kΩ; the 120 µA and 180 µA figures are removed. (5) Stale LAYOUT/SPEC text (55 × 35 mm, unfilled, unstitched, not manufacturable, the 9af7427 VIN_RAW bullet) struck; pcb.copper_oz updated. (6) The FB1 rating cites datasheet-verification.md. (7) DEVPLAN gains T13 shorted output, T14 J2-screw Vout and T15 hot-plug/C10; R4 dropped; T5 uses TP8. | why: The 80 mΩ bound would admit a substitute whose ESR zero falls below crossover. The 80–85 °C Tj hid a 7 °C margin. The T10 pass criterion would have accepted a damaged Q1. The bench tests decide E5, E7 and E9 before rev E layout. No budget is broken and no part changes. | why: Bring the design record in line with the datasheet equations and the circuit before rev E is designed from it (rev E proposal §5/§7). | affects: C5, C6, L1, U1, Q1, D2, R1, D3, C10, FB1, TP5, TP8, J2, power.output_filter_compensation, thermal.tj_max_C, pcb.copper_oz, docs/SPEC.md, docs/SUBSYSTEMS.md, docs/BOM.md, docs/LAYOUT.md, docs/DEVPLAN.md, docs/CHANGELOG.md
- 2026-11-07 [run 2026-11-07T00-08-55-657Z] Change docs-r5-verified-t10-idss-d3-thermal (2026-11-07), docs only. (1) R5 0603WAF0000T5E (LCSC C21189) is marked VERIFIED in docs/BOM.md and SUBSYSTEMS §5 from research/parts/datasheet-verification.md: Uniroyal SMD-SP-001 version 9 (Jun. 21, 2025), section 7 Ratings, 0603 jumper < 50 mΩ, 1 A rated, 2 A overload, −55 to +155 °C, read 2026-11-06. (2) DEVPLAN T10 pass limit: reverse Iin ≤ 1 µA at −9/−12/−18 V with the board at room temperature, from DMP6023LE IDSS −1 µA max at VDS −60 V, VGS 0 V, TJ 25 °C (DS37199 rev 3-2). If warm, allow 1 µA × 2^((T−25)/10) as a typical-behaviour allowance (not a datasheet limit) or re-test cold; > ~10 µA investigate; ~0.2 mA stop. (3) SUBSYSTEMS §3/§9 cite B560C RθJT 10 °C/W, RθJA 50 °C/W (DS13012 rev 19-2) from datasheet-verification.md, closing the thermal half of B.F6. | why: R5 is the only link from J3/TP7 (EN_EXT) to U1 EN; while UNVERIFIED the JLCPCB BOM export drops it, so the assembled board would lose external enable (assembly.qty). The datasheet 25 °C IDSS is the only guaranteed figure, so T10 is run cold against it and any warm allowance is labelled as an estimate rather than invented as a limit (protection.reverse_polarity_V). The RθJT/RθJA citation moves D3 cooling from a read note to the verification record (thermal.component_rise_C). No budget, part or net changes. | affects: R5, Q1, D3, EN_EXT, EN, docs/BOM.md, docs/DEVPLAN.md T10, docs/SUBSYSTEMS.md §1/§3/§5/§9, docs/CHANGELOG.md, outputs/jlcpcb-bom.csv (re-export pending), assembly.qty, protection.reverse_polarity_V, thermal.component_rise_C
- 2026-11-07 [run 2026-11-07T00-13-08-821Z] Change rev-e-lockup-front-silk (2026-11-07). The rev E front-silkscreen branding changes. The 4 mm copperhead mark from a534656 (change copperhead-mark-front-silk) is deleted: gr_circle (104, 136.5) r 0.92 mm and four ticks, uuids c0ffeeaa-0e00-…-0001 to -0005. In its place are the copperhead lockup and a board label, as the person asked on 2026-11-06. The lockup is the 11 filled F.SilkS gr_poly items from lib/branding/rev-e-lockup-board-graphics.kicad_sexp, inserted verbatim and unscaled at x 101.5–115.9, y 135.6–137.46. The label is gr_text 'tps5430/rev-e', 1.0 mm size, 0.15 mm thickness, left-justified at (101.5, 138.6). The person also put the same branding on the public GitHub copy of rev D as tps5430/rev-d. The frozen releases/rev-d/ in this workspace is untouched and has no branding. There is no net, footprint, copper, zone, schematic, BOM, position-file, releases/ or outputs/ change. DRC is clean with no silk findings, and ERC and drift are clean. | why: docs/BRIEF.md Physical (2026-11-06, commit f1a6f4b) asks for the lockup with the board name and revision below it, to match the STM32 data logger board. Native board graphics stay out of the BOM, CPL and parity, and silkscreen-only geometry over tented vias leaves every electrical and clearance constraint untouched. | affects: F.SilkS, tps5430-12-v-to-5-v-industrial-buck-converter.kicad_pcb, docs/LAYOUT.md Silkscreen, docs/CHANGELOG.md, openspec/changes/rev-e-lockup-front-silk, openspec/changes/copperhead-mark-front-silk (superseded), earlier DECISIONS entry copperhead-mark-front-silk (superseded), outputs/ (stale until next export)
- 2026-11-07 [run 2026-11-07T13-58-21-533Z] Option A power stage (board commit 55dc4db), chosen by the person on 2026-11-07 over option B. It was made outside copperhead do with research/proposals/rev-e/power-stage-loop/scripts/option_a_layout.py and a kicad-cli zone refill. Moves: C1 to (131.4, 127.4) −90°, D3 to (136.4, 128.0) −90°, C3 to (134.7, 121.0) 0°, TP5 to (129.3, 122.0) and TP8 to (131.45, 121.6). VIN_BUCK is now a single B.Cu hop. SW runs 2.0 mm straight at y 124.0. The commit postdates rev D (1393414), so it belongs to rev E. outputs/ is stale until the next export. | why: docs/BRIEF.md Physical asks for a tight high-current switching loop with the catch diode and input bypass capacitor adjacent to the regulator. Option B (keep E1) only reached about 40.3 mm² and 8.7 nH, while option A reached about 30 mm² (power-stage-loop-analysis.md §5, §6, §9). copperhead do cannot refill zones, so the person made the change in KiCad. | affects: C1, C3, D3, TP5, TP8, VIN_BUCK, SW, GND, docs/LAYOUT.md, docs/SPEC.md §6, docs/SUBSYSTEMS.md §0/§3, docs/DEVPLAN.md T5, openspec/changes/docs-sync-board-55dc4db-option-a, outputs/ (stale)
- 2026-11-07 [run 2026-11-07T13-58-21-533Z] C1 (10 µF), not C3, now closes the commutation loop at U1 pins 7/6. Its VIN pad is on pin 7 copper and its GND pad is fed from pin 6 on F.Cu between C1's pads, with no via in the C1–U1–D3 loop. C3 (100 nF) moved upstream to the VIN_BUCK hop. This partly reverses E1 (c502f61). The E1 openspec requirement 'HF input capacitor loop on F.Cu without vias' is modified to name C1, and SPEC §6 is reworded to match. | why: In the commutation loop (C_in → VIN → PH → D3 → GND → C_in), U1's GND pin and PowerPAD are not in the path, so the capacitor that closes the loop has to sit between pin 7 and the D3 anode (power-stage-loop-analysis.md §3.1). At the pins, C1 also decouples U1 almost as well as C3 did (≈ 2.7 nH against 2.0 nH). | affects: C1, C3, U1 pins 6/7, D3, openspec requirement 'HF input capacitor loop on F.Cu without vias', docs/SPEC.md §6, docs/SUBSYSTEMS.md §3, earlier DECISIONS entry for rev E E1 (partly superseded)
- 2026-11-07 [run 2026-11-07T13-58-21-533Z] As-routed results of option A, person-reported from scripts/loop_inductance.py:
- commutation loop 46.1 → 30.4 mm² routed;
- 9.8 → 6.9 nH with the B.Cu plane;
- diode leg 10.6 → 8.1 nH;
- U1 local decoupling 2.0 → ≈ 2.7 nH (accepted);
- SW copper 47.1 → 48.1 mm², all F.Cu;
- B.Cu GND slot 10.5 × 2.6 mm → ≈ 5.2 × 1.6 mm, one hop.

VIN_BUCK crosses SW once: C2 → C3.1 → V1 via pair (132.95/133.75, 122.3) → 1.5 mm B.Cu hop → V2 via pair (133.35, 125.9/126.7) → C1.1. The x 133.6 B.Cu run and its six vias are gone. These figures are not in any file in the workspace, so they are recorded as the person's. | why: Routed-path area is the method behind the 46.1 mm² baseline (analysis §1.2, §9 item 3). On two layers, with PH above VIN and every VIN_BUCK source above the SW run, VIN must cross SW once (analysis §4). One short hop is the minimum. The plan targeted 28.4 mm² and 6.5 nH; the as-routed 30.4 mm² is under the 32 mm² stop threshold of option-a-plan.md step 4. The slightly worse U1 self-decoupling is the accepted cost of favouring the commutation loop. | affects: VIN_BUCK, SW, GND_pour_B.Cu, C1, C3, D3, U1, openspec ADDED requirement 'VIN_BUCK crosses under SW at most once', docs/LAYOUT.md Option A section
- 2026-11-07 [run 2026-11-07T13-58-21-533Z] About 28–30 mm² of commutation loop (routed) is accepted as the floor with the B560C in SMC and a 1210 C1. The brief is unchanged.

The person chose to make the layout change before rev D bring-up, which reverses the 'bench first' decision in power-stage-loop-analysis.md §9. The diode choice (E9) is therefore still open. If the shorted-output test (DEVPLAN T13) calls for an 8 A or larger part on a different land, the D3 position and the C1–D3 junction are redone. Rev D bring-up tests the old layout; its thermal and short-circuit results still apply to the parts. | why: Getting below about 26 mm² needs a smaller diode package or C1 case. Both are named in docs/BRIEF.md Parts, and the C1/D3 courtyards and D3's 6.8 mm pad span set the floor (analysis §5). Doing the layout first lets rev E carry the smaller loop. The cost is a possible D3-area redo if E9 changes the part. | affects: D3, C1, E9 (open), DEVPLAN T5/T8/T13, thermal.component_rise_C (still a bench check), docs/BRIEF.md (unchanged)
- 2026-11-07 [run 2026-11-07T17-23-51-878Z] Board commit fb7cc21 (2026-11-07, rev E; KiCad pcbnew script and kicad-cli zone refill outside copperhead do, at the person's request) deleted three 0.5 mm F.Cu GND stubs. Two ran from the D3.2 anode to the vias at (135.2/137.6, 134.75), from y 132.4. The third ran from R1.2 (136.825, 112) up to (136.825, 110.325) and 45° into the D1.2 GND via at (136.5, 110). The vias, the 1.5 mm D3 anode trunk at x 136.4, the D1.2 1.0 mm stubs and B.Cu strap, and the zone fill are unchanged. R1.2 and the vias stay on GND through the F.Cu pour. outputs/ is stale until the next export. Recorded by change docs-sync-board-fb7cc21-gnd-stubs, which edits docs only. | why: The stubs were redundant copper inside the solid F.Cu GND pour: D3.2, D1.2 and R1.2 all have pad-level zone_connect 2, so the stubs carried no current of their own. They read as hairline traces under D3 and beside D1, which looks like a routing error. Removing them changes no connectivity, current path or thermal path, so thermal.component_rise_C, the TVS surge return and pcb.min_clearance_mm are unaffected. | affects: D3.2, D1.2, R1.2, GND vias (135.2/137.6, 134.75) and (136.5, 110), GND_pour_F.Cu, docs/LAYOUT.md, docs/CHANGELOG.md, outputs/ (stale), earlier entries q1-pin2-r1-gnd-links, gnd-stitching-vias-density, docs-sync-board-9af7427 and docs-sync-board-55dc4db-option-a (stub descriptions superseded)
- 2026-11-07 [run 2026-11-07T17-36-06-952Z] Board commit d4738e0 (2026-11-07, rev E; move_branding.py and kicad-cli zone refill outside copperhead do, at the person's request) moved the copperhead lockup and the tps5430/rev-e label together by (+0.5, −1.45) mm to x 102.0–116.4, y 134.15–138.0, 2.0 mm from both the left and the bottom edge (was 1.5 and 0.55 mm), label still directly below the lockup. TP7's EN name moved from left of TP7 to above-left (x 118.1–119.9, y 132.0–133.4). Recorded by change docs-sync-board-ground-stitching-branding; outputs/ stale until the next export. | why: The person asked for equal margins to the left and bottom edges; at 0.55 mm from the bottom edge the artwork looked cramped. Left of TP7, the EN name read as part of the lockup; above-left it stays clear of both the lockup and the J3 reference. Silkscreen only: no net, copper or clearance constraint is affected (docs/BRIEF.md Physical). | affects: F.SilkS lockup and label, TP7 EN name, docs/LAYOUT.md Silkscreen, openspec branding requirement, outputs/ (stale)
- 2026-11-07 [run 2026-11-07T17-36-06-952Z] GND stitching redo, board commits bf2e241 and e453b54 (2026-11-07, rev E; stitching.py and kicad-cli zone refill outside copperhead do, at the person's request; plan research/proposals/rev-e/ground-stitching/stitching-plan.md). Kept 22 functional GND vias (GND track end, D3 courtyard, or within 3.6 mm of D3.2/D1.2/C1.2/C2.2/C5.2/C6.2) and removed the other 82. Added 148 tented 0.6/0.3 mm vias where both GND fills overlap with 0.35 mm to spare: ring within 1.6 mm of SW copper 28, edge fence at 2.5 mm pitch 1.4 mm in 55, 3.75 mm grid plus gap fill to 3 mm 65. No new via in a courtyard other than L1, J1, J2, D3, U1, and none under the lockup and label. GND vias 104 → 170, drill +66 holes, mean distance 2.12 → 1.79 mm. Largest gap 8.2 mm under the label on purpose; elsewhere worst about 5.3 mm beside C5. bf2e241 broke the 1 mm quiet-copper rule (FB, EN, EN_EXT, R2.1 Kelvin run) for 8 vias, which KiCad DRC cannot check; e453b54 fixed it. outputs/ stale. | why: The old vias were added ad hoc in stages, with uneven coverage and no edge fence. A ring, fence and regular grid tie the two pours together where return currents and edge radiation are. The worst spacing, about 5 mm, is far below λ/20 at 1 GHz in FR-4 (about 7 mm); SW ringing is calculated at 130–180 MHz. The quiet-copper rule protects power.vout_V (FB, Kelvin) and protection.ena_pin_max_V (EN), and courtyard keep-outs protect assembly (assembly.qty). | affects: GND net, GND_pour_F.Cu, GND_pour_B.Cu, drill file, FB, EN, EN_EXT, R2.1 Kelvin run, docs/LAYOUT.md stitching section, docs/SPEC.md §6, pcb.copper_oz, earlier entries r1-solid-gnd-stitching-vias, gnd-stitching-vias-density, docs-sync-board-9af7427 (via lists superseded)
- 2026-11-07 [run 2026-11-07T18-35-49-068Z] Board commits cc082ae and 9493399 (2026-11-07, rev E) were made with a pcbnew script outside copperhead do, at the person's request. They moved TP8 (TP_GND3) from (131.45, 121.6) to (131.85, 121.3), rotation 0. 9493399 restores the cc082ae position after f05b01f reverted it by writing an older board copy. Centre spacing to TP5 went from 2.2 to 2.65 mm, the pad-edge gap from 1.15 to 1.55 mm, and the courtyards no longer touch. The 1.5 mm VIN_BUCK track end at (132.6, 119.8) limits the position, at 0.28 mm clearance. The TP8 reference moved to (132.1, 119.95). The solid GND connection and the zone fill are unchanged. The f05b01f +5V Kelvin widening (0.25 → 0.40 mm) is a separate change and is not recorded here. outputs/ is stale until the next export. Recorded by change docs-sync-board-tp8-spacing. | why: The person asked for more spacing between the SW and GND probe pads, so a probe tip and ground spring are less likely to bridge them. 2.65 mm is still inside rev E E6's 2–3 mm (docs/BRIEF.md Interfaces), and the move changes no net, copper rule or clearance below 0.2 mm (pcb.min_clearance_mm). | affects: TP8, TP5, VIN_BUCK track end, TP8 reference silk, docs/LAYOUT.md, docs/DEVPLAN.md T5, docs/CHANGELOG.md, outputs/ (stale)
- 2026-11-07 [run 2026-11-07T18-38-03-396Z] Board commit f05b01f (2026-11-07, rev E) was made with kelvin_variants.py `wide` and a kicad-cli zone refill, outside copperhead do at the person's request. It widens the +5V R2.1 Kelvin sense run (C5.1 → R2.1) from 0.25 to 0.40 mm on all five segments, on the same route: F.Cu (141, 116.8) → via (139.4, 116.8) → B.Cu along y 116.8 and down x 117.3 → via (117.3, 127.2) → F.Cu to R2.1. The run stays 32.4 mm on B.Cu. The B.Cu GND slot is 0.15 mm wider. No GND via moved, and every GND via edge stays ≥ 1 mm from the run. stitching.py now finds the run by tracing narrow +5V copper from R2.1. Three options were compared (keep, shorten to a 26.4 mm diagonal, widen); widen was chosen. outputs/ is stale until the next export. Recorded by change docs-sync-board-f05b01f-kelvin-width. | why: A 0.25 mm, 32 mm run read as a hairline and is fragile to etch and handle. It carries only the R2/R3 divider current (≈ 0.38 mA), so width has no electrical effect and the sense point stays at C5 (power.vout_V). Widening kept the route and the 1 mm quiet-copper margin. The shorter diagonal would have re-routed the run through the stitched GND area and disturbed that margin and the via pattern. pcb.min_clearance_mm still holds, confirmed by the person's KiCad DRC with refill (0 violations). | affects: +5V R2.1 Kelvin run, R2.1, C5.1, GND_pour_B.Cu slot, stitching.py, docs/LAYOUT.md, docs/CHANGELOG.md, outputs/ (stale), power.vout_V, earlier entries route-high-current-paths and gnd-stitching-vias-density (0.25 mm width superseded)
- 2026-11-07 [run 2026-11-07T18-51-51-540Z] Change kicad-pro-teardrop-track-to-track (2026-11-07), project setting only. In tps5430-12-v-to-5-v-industrial-buck-converter.kicad_pro under board.design_settings, added teardrop_options with td_ontrackend true (Board Setup > Design Rules > Teardrops > Track to track). The rest are KiCad defaults: td_onvia, td_onsmdpad and td_onpthpad true, td_onroundshapesonly false. Also added teardrop_parameters for td_round_shape, td_rect_shape and td_track_end, each at length ratio 0.5, max length 1.0 mm, height ratio 1.0, max height 2.0 mm, width-to-size filter 0.9, two-track spans allowed, straight edges, and no teardrop on pads inside a zone. The file had no teardrop block before. No .kicad_pcb, .kicad_sch, schematic.intent.json, outputs/ or releases/ edit, and no copper, net, value, part or footprint change. The pad and via teardrop flags on the board items, and the zone refill that generates the teardrops, follow as a separate person-made board commit, because copperhead do cannot refill zones. Until then the board has no teardrops. ERC, DRC and drift are clean. | why: The person asked for teardrops on 2026-11-07 for mechanical and etch robustness on a board installed in an industrial cabinet (docs/BRIEF.md Environment). The narrow-into-wide joints are the weak points: the 0.3 mm LED feed tee into the 2 mm +5V trunk at (157.5, 118.6), the SW width steps at U1 PH, VIN_PROT stepping from 1.0 to 2.0 mm at Q1, and about 45 track-to-pad/via joints. Track-to-track teardrops are off by default in KiCad, so this option must be set before the refill. KiCad defaults keep teardrop size bounded at 1 mm long and 2 mm high, so the later refill will be checked against pcb.min_clearance_mm by KiCad DRC. | affects: tps5430-12-v-to-5-v-industrial-buck-converter.kicad_pro (board.design_settings teardrop_options, teardrop_parameters); future board commit (teardrop flags and zone refill); +5V/LED feed tee, SW at U1 PH, VIN_PROT at Q1, track-to-pad/via joints; pcb.min_clearance_mm (checked at refill); docs/CHANGELOG.md; outputs/ (unchanged; stale until the next export)
- 2026-11-07 [run 2026-11-07T18-54-50-583Z] Board commit 215da06 (2026-11-07, rev E) added teardrops. It was made with research/proposals/rev-e/teardrops/scripts/teardrops.py and a kicad-cli zone refill, outside copperhead do at the person's request, because copperhead do cannot refill zones.

What the commit did:
- Teardrop flag set on every pad (82) except C5.1, and on every via (178), with KiCad default parameters (87c1c40).
- The refill generated 44 padvia teardrop zones (+5V 6, FB 5, /Q1_GATE 4, VIN_BUCK 4, GND 4, EN 3, /EN_EXT 3, VIN_PROT 3, VIN_FUSED 3, SW 3, /LED_A 2, /VIN_RAW 2, /BOOT 2).
- C5.1 is skipped. Its teardrop on the 0.40 mm Kelvin run came 0.68 mm from the GND via at (140.75, 118.75), inside the 1 mm quiet-copper rule, and C5.1 is a 3.5 × 2.5 mm pad.

Correction to the 87c1c40 entry (kicad-pro-teardrop-track-to-track), kept as written: it expected the refill to generate track-to-track teardrops. It did not. kicad-cli's zone refill builds pad and via teardrops only, so td_ontrackend produced nothing. The six track-to-track junctions have no teardrop: the LED feed tee at (157.5, 118.6), the SW 0.5/1.0/2.0 mm steps at U1 PH, and VIN_PROT 1.0 to 2.0 mm at Q1. They would need KiCad's Edit > Edit Teardrops in the editor.

outputs/ is stale until the next export. Recorded by change docs-sync-board-215da06-teardrops. | why: Teardrops give etch and mechanical robustness at narrow-to-wide joints on a board installed in an industrial cabinet (docs/BRIEF.md Environment). JLCPCB does not require them. Skipping C5.1 keeps the quiet-copper margin that protects power.vout_V; KiCad DRC cannot check that margin. pcb.min_clearance_mm holds per the person's refilled DRC (0 violations). | affects: All pads except C5.1, all 178 vias, 44 teardrop zones, C5.1, R2.1 Kelvin run, GND via (140.75, 118.75), docs/LAYOUT.md Teardrops section, docs/CHANGELOG.md, openspec/changes/docs-sync-board-215da06-teardrops, earlier DECISIONS entry kicad-pro-teardrop-track-to-track (expectation corrected), outputs/ (stale)
- 2026-11-07 [run 2026-11-07T19-57-40-659Z] Board commit f862007 (2026-11-07, rev E; tjoint_fillets.py and a kicad-cli zone refill outside copperhead do, at the person's request) added two teardrop-shaped copper fillets as filled F.Cu graphic polygons with nets. One is on +5V at the C6 tee (0.3 mm LED feed ending at (157.5, 118.6) inside the 2 mm trunk corner; hull of r 0.15 mm at (157.5, 119.9) and r 0.5 mm at (157.5, 118.6)). The other is on SW at the PH step (1.0 mm PH track ending at (129.9, 124.6) inside the 2.0 mm SW run; hull of r 0.5 mm at (129.1, 124.595) and r 1.0 mm at (130.5, 124.0)). SW F.Cu copper is 48.2 → 48.4 mm². This corrects the 215da06 entry, kept as written: of the six track-to-track junctions it listed without teardrops, the C6 tee and SW step now have fillets, and the rest end on pads (pad teardrops) or are equal-width VIN_BUCK joints. The 'minimal switch-node copper' requirement is modified to allow the SW fillet. outputs/ is stale until the next export. Recorded by change docs-sync-board-f862007-tjoint-fillets. | why: KiCad's teardrop tool skips T-joints where a narrow track ends inside another track: neither the kicad-cli refill nor Edit > Edit Teardrops (tried 2026-11-07) adds one. Graphic copper with a net survives refills and is DRC-checked, giving these joints the same etch and mechanical robustness as the pad teardrops (docs/BRIEF.md Environment). The 0.2 mm SW copper increase is negligible against the switch-node area, and DRC with refill is clean (pcb.min_clearance_mm). | affects: +5V C6 tee, SW at U1 PH, docs/LAYOUT.md, docs/SUBSYSTEMS.md §3, openspec minimal switch-node copper requirement, earlier DECISIONS entry docs-sync-board-215da06-teardrops (track-to-track statement corrected), outputs/ (stale)
- 2026-11-07 [run 2026-11-07T20-01-07-372Z] Board commit aa520d7 (2026-11-07, rev E; tjoint_fillets.py and a kicad-cli zone refill outside copperhead do, at the person's request) replaces the two rounded T-joint fillets of f862007 (convex hulls of two circles, uuids 1177ddbc-…, 97729a92-…) with straight-sided tapered filled F.Cu polygons on the joint's net. +5V at the C6 tee (uuid 96dd1a03-…): (157.0, 118.3), (157.8, 118.22), (157.65, 119.9), (157.35, 119.9), (157.08, 119.35), its right edge continuing the trunk's x 157.8 edge down to the 0.3 mm LED feed. SW at U1 PH (uuid 307e574f-…): (129.1, 124.095), (130.5, 123.0), (130.9, 123.0), (130.9, 125.0), (130.5, 125.0), (129.1, 125.095), straight from the 1.0 mm track's edges to the corners of the 2.0 mm run. SW F.Cu copper 48.4 → 48.3 mm² (48.2 before any fillet). The f862007 openspec requirement ('teardrop-shaped') is MODIFIED to 'tapered copper fillet with straight edges'. This supersedes the shape described in the f862007 DECISIONS entry, which is kept as written. outputs/ is stale until the next export. Recorded by change docs-sync-board-aa520d7-straight-fillets. | why: The person asked for straight geometry. The straight taper still spans from the narrow track into the wide one, so it keeps the etch and mechanical robustness of the fillet (docs/BRIEF.md Environment); SW copper falls slightly, and the person's refilled KiCad DRC is clean (pcb.min_clearance_mm). Neither fillet touches FB, EN, EN_EXT or the Kelvin run, so the 1 mm quiet-copper rule is unaffected. | affects: +5V C6 tee, SW at U1 PH, docs/LAYOUT.md, docs/SUBSYSTEMS.md §3, openspec requirements 'copper fillets at narrow-into-wide T-joints' and 'minimal switch-node copper', earlier DECISIONS entry docs-sync-board-f862007-tjoint-fillets (shape superseded), outputs/ (stale)
- 2026-11-07 [run 2026-11-07T20-07-10-260Z] Board commit eb651e0 (2026-11-07, rev E; c6_branch_shift.py and a kicad-cli zone refill outside copperhead do, at the person's request) shifts the 0.3 mm +5V LED feed and its downstream parts by +0.15 mm in x. R4 moves from (157.5, 123.5) −90° to (157.65, 123.5) −90°, and D4 from (157.5, 127.0) 90° to (157.65, 127.0) 90°. The feed now runs (157.65, 118.22) → R4.1 (157.65, 122.675), flush with the 2 mm trunk's right edge at x 157.8 and starting level with its corner. /LED_A runs x 157.65 from 124.325 to 126.213. The aa520d7 +5V C6-tee fillet (96dd1a03-…) is replaced by a straight-edged triangle in the V between the feed and the trunk's diagonal (2515ecc8-…: (157.65, 118.75), (156.9, 119.45), (157.55, 119.75)). The SW fillet is unchanged, and tjoint_fillets.py now handles only the SW fillet. The openspec T-joint requirement is MODIFIED to allow a V fillet at a flush joint. outputs/ (including the placement file) is stale until the next export. Recorded by change docs-sync-board-eb651e0-c6-branch-shift; this supersedes the +5V shape in the aa520d7 entry, which is kept as written. | why: The person asked to shift the trace and its downstream parts so the feed meets the trunk flush, with a fillet at the joint, instead of a large fillet bridging an off-centre joint. Etch and mechanical robustness are kept (docs/BRIEF.md Environment). No net, value or part changes. The LED stays on +5V away from SW, and the person's refilled DRC is clean (pcb.min_clearance_mm). | affects: R4, D4, +5V LED feed, /LED_A, +5V C6-tee fillet, docs/LAYOUT.md, docs/CHANGELOG.md, openspec T-joint requirement, earlier DECISIONS entry docs-sync-board-aa520d7-straight-fillets (+5V shape superseded), outputs/ placement file (stale)
- 2026-11-07 [run 2026-11-07T20-21-12-397Z] Board commit 79270d0 (2026-11-07, rev E; altium_teardrops.py and a kicad-cli zone refill outside copperhead do, at the person's request) replaces all earlier teardrops and fillets with Altium-dialog-style curved ones. Pads and vias: per-item KiCad teardrops sized from the entering track width (via/TH 30 % of d long, 70 % wide; SMD 100 %/200 % of track width), curved, enabled on 56 pads and 15 vias, 48 zones generated and clipped by the refill; C5.1 included again because at these sizes it keeps the 1 mm quiet rule. Tracks and T-junctions: 23 curved filled F.Cu gr_poly fillets on the joint's net (width change over 100 % of the wider width; T-junction 100 % of the narrower width), shrunk to clear other nets by 0.25 mm and quiet-net GND vias by 1 mm; 4 skipped for room; GND joints skipped (inside the solid pour); SW step at U1 PH hand-drawn. The straight fillets of aa520d7 and eb651e0 are replaced; the eb651e0 LED branch shift stays. SW copper changed slightly, not re-measured. outputs/ stale until the next export. Recorded by change docs-sync-board-79270d0-altium-teardrops; supersedes the teardrop/fillet shapes of the 215da06, f862007, aa520d7 and eb651e0 entries, which are kept as written. | why: The person asked for teardrops on every joint, via, track and pad in Altium's style, for mechanical and etch robustness on a board in an industrial cabinet (docs/BRIEF.md Environment). Shrinking to clearance keeps pcb.min_clearance_mm and the 1 mm quiet-copper rule that protects power.vout_V and protection.ena_pin_max_V; the person's refilled KiCad DRC with parity is clean. | affects: all track-entered pads and vias, C5.1, VIN_BUCK, VIN_PROT, +5V, SW, EN, FB, /EN_EXT joints, docs/LAYOUT.md, docs/SUBSYSTEMS.md §3, openspec teardrop and T-joint fillet requirements, earlier DECISIONS entries 215da06/f862007/aa520d7/eb651e0 (shapes superseded), outputs/ (stale)
- 2026-11-07 [run 2026-11-07T20-29-59-083Z] Board commit 01c54ce (2026-11-07, rev E; altium_teardrops.py and a kicad-cli zone refill outside copperhead do, at the person's request) sizes T-junction fillets from the trunk's (wider track's) width, 100 % along the trunk and up the branch, instead of 100 % of the narrower width as in 79270d0. Still clamped to existing copper along each arm and shrunk for 0.25 mm clearance and the 1 mm quiet-copper rule. Effect (person-reported): C6-tee fillet about 0.3 → 2 mm; equal-width corners (FB, EN, /EN_EXT, VIN_PROT, SW at C4) unchanged; VIN_BUCK fillets at the 1.5 mm track larger, (132.6, 119.8) at half size; the same 4 joints skipped. The openspec teardrop requirement is MODIFIED by change docs-sync-board-01c54ce-tjunction-trunk-width. outputs/ stale until the next export. Supersedes the T-junction rule of the 79270d0 entry, kept as written. | why: The person found the C6-tee fillet radius too small, and Altium's Teardrops dialog diagram measures w on the trunk, so sizing from the narrow branch under-sized narrow-into-wide joints. Etch and mechanical robustness in an industrial cabinet (docs/BRIEF.md Environment); the clearance shrink keeps pcb.min_clearance_mm and the quiet-copper rule protecting power.vout_V and protection.ena_pin_max_V, and the person's refilled KiCad DRC with parity is clean. | affects: +5V C6 tee, VIN_BUCK T-junctions, docs/LAYOUT.md Teardrops and fillets, openspec teardrop requirement, earlier DECISIONS entry docs-sync-board-79270d0-altium-teardrops (T-junction rule superseded), outputs/ (stale)
- 2026-11-07 [run 2026-11-07T20-46-48-672Z] Change fab-note-heading-rev-e (2026-11-07): the heading of the Cmts.User fab-note gr_text on the board changes from 'FAB NOTES (rev A):' to 'FAB NOTES (rev E):'. The three notes, position (100, 143), size and layer are unchanged. No copper, net, footprint, zone, schematic, BOM, releases/ or outputs/ change. | why: Rev E is about to be released (person's request 2026-11-07) and the release freezes the design files; a fab note naming rev A on a rev E board would mislabel the frozen package. User.Comments is not a fab layer, so no electrical, clearance or fabrication constraint is affected. | affects: Cmts.User fab note, tps5430-12-v-to-5-v-industrial-buck-converter.kicad_pcb, docs/CHANGELOG.md, rev E release, outputs/ (stale until next export)
