copperheadhq/copperhead-tps5430-buck-converter/images/board-back.png

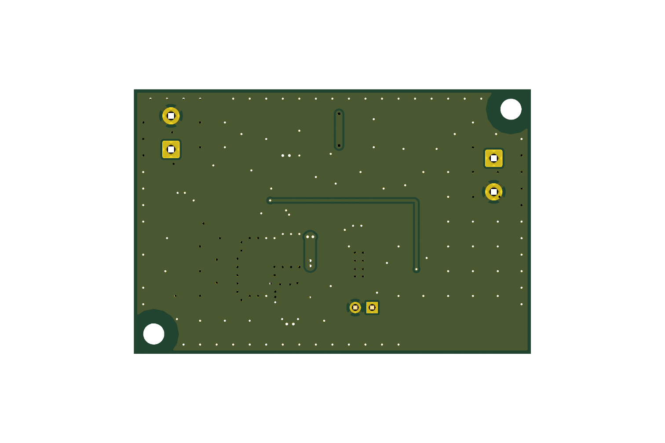
images/board-back.png
