copperheadhq/copperhead-tps5430-buck-converter/docs/BOM.md

# Bill of materials: TPS5430 12 V to 5 V industrial buck converter

Stage 3 (part selection), updated 2026-11-06 by change bom-datasheet-verification. One row per refdes. Every fitted part was checked against its manufacturer datasheet on 2026-11-06 (research/parts/datasheet-verification.md). Figures marked VERIFIED cite the datasheet revision and page from that note. Figures read only from a typical curve are labelled as such, because they are not guaranteed limits. Live stock and lifecycle are not checked (SPEC §7).
Symbols are installed and pin-confirmed with symbol_pins; footprints are installed and confirmed with check_footprints. The symbol lib_id for each row is given in its Rationale.

LCSC numbers for JLCPCB assembly (docs/BRIEF.md Physical) come from research/parts/jlcpcb-sourcing.md (chosen 2026-11-06; stock read from the JLCPCB parts API that day, recheck before ordering). Listing figures have since been checked against the manufacturer datasheets (research/parts/datasheet-verification.md, 2026-11-06); the datasheet value replaces the listing value wherever they differ. The LCSC cell is empty on purpose for parts that are not fitted (C7, C8, C10, J3) and for items that are not parts (TP1–TP8, H1, H2). C10 (rev E bulk input capacitor footprint) and TP8 (rev E GND probe pad) carry the no-part marker `—` from change rev-e-en-series-bulk-cap-gnd-probe, so they are omitted the same way. All of these rows carry the no-part marker `—` in the MPN cell, so the generated JLCPCB BOM (`copperhead export bom --supplier jlcpcb`) omits them: C7, C8 and J3 (DNP in rev A to E) since change bom-dnp-no-part-marker (rev E, E11; before it their MPN read `DNP` and J3 was emitted as a fitted line valued EN, C7/C8 as a line valued DNP), and TP1–TP7, H1, H2 as before. The DNP state lives here and in the board's `exclude_from_pos_files`; the schematic symbols still read `(in_bom yes) (dnp no)` because the drafting engine cannot set the DNP attribute. C9 is fitted from change fit-c9-en-filter (2026-11-06) and carries LCSC C1588.
TP1–TP7 board footprints (change tp-in-bom-schematic-parity, 2026-11-06): they no longer carry `exclude_from_bom`, so they match the drafted schematic symbols (always `in_bom yes`) and pass KiCad's schematic-parity check. They keep `exclude_from_pos_files`, so they stay out of the pick-and-place (CPL) file. They also stay out of the JLCPCB assembly BOM, because that BOM is generated from this file, where TP1–TP7 have no LCSC number and are bare pads (`assembly.qty`). KiCad's own BOM export will list them; that list is not the assembly BOM.
C7, C8 and J3 board footprints (change dnp-exclude-from-pos, 2026-11-06; C9 was in this list until change fit-c9-en-filter, 2026-11-06, which fitted it and removed `exclude_from_pos_files` from its footprint, so C9 is now placed): these are not fitted in rev A, so they carry `exclude_from_pos_files` and stay out of the pick-and-place (CPL) file. Before this change `kicad-cli pcb export pos` listed them, so an assembler could have placed them (design review finding assembly-parity.dnp-placed). `exclude_from_bom` is left unset on purpose, so the footprints still match the drafted schematic symbols (always `in_bom yes`) and KiCad's schematic-parity check stays clean. They stay out of the JLCPCB assembly BOM because it is generated from this file, where their MPN cell is the no-part marker `—` (change bom-dnp-no-part-marker, rev E) and they have no LCSC number. If any of them is fitted in a later revision, remove `exclude_from_pos_files` from that footprint. C10 (rev E, not fitted) follows the same rule: its footprint carries `(attr smd exclude_from_pos_files)` as placed in board commits 06b32da/373fb8f. TP8 carries `(attr exclude_from_pos_files)` only, like TP1–TP7. R5 is fitted and carries `(attr smd)`.

| Refdes | Value | Footprint | MPN | Rationale | LCSC |
|---|---|---|---|---|---|
| U1 | TPS5430DDAR | Package_SO:TI_SO-PowerPAD-8_ThermalVias | TPS5430DDAR | Symbol Regulator_Switching:TPS5430DDA (BOOT=1, NC=2,3, VSENSE=4, EN=5, GND=6, VIN=7, PH=8, PAD=9). VERIFIED (TI SLVS632L rev L, April 2026, pp. 1, 3–5): pinout; 5.5–36 V VIN; 3 A; 500 kHz; Vref 1.221 V (1.196–1.245 V over temperature); internal 1.5 MΩ ENA pull-up; shutdown 15 µA typ, 50 µA max; ENA abs max 7 V; high-side current limit IHS(OC) 4.0 A min, 5.0 A typ, 6.0 A max (p. 5; the 6.0 A max sets the L1 Isat criterion). Correction: quiescent current is 2 mA typ, 4.4 mA max (was taken as ~3 mA); the no-load roll-up below uses 4.4 mA. The datasheet says not to tie ENA to GND through a resistor, and the design has no such resistor. | C9864 |
| Q1 | DMP6023LE | Package_TO_SOT_SMD:SOT-223-3_TabPin2 | DMP6023LE-13 | Symbol Transistor_FET:Q_PMOS_GDS (G=1, D=2, S=3, tab=D). Reverse-polarity P-FET, drain VIN_FUSED, source VIN_PROT. VERIFIED (Diodes DS37199 rev 3-2, Jan 2015, marked Advance Information, pp. 1–2): Vds −60 V (2.07× the 29 V clamp); Vgs ±20 V; RDS(on) 28 mΩ max at Vgs −10 V; IDM −50 A, above the SMBJ18A Ipp of 20.5 A. Pin order: the drawing has no pin numbers, but G, D, S along the lead row with D on the tab matches standard SOT-223 numbering and SOT-223-3_TabPin2. Check the marking at bring-up. | C154901 |
| F1 | 4A | Fuse:Fuseholder_Littelfuse_Nano2_154x | 0154004.DRT | Symbol Device:Fuse. 4 A slow-blow in an OMNI-BLOK holder, per docs/BRIEF.md Parts (decided 2026-11-05, research/parts/input-fuse.md). At the 1.96 A worst-case input it runs at ~49 % of rating, inside the 75 % continuous guideline with margin for 50 °C derating. This closes SPEC §9 Q1. Same footprint as the 3 A 0154003.DRT it replaces. VERIFIED (Littelfuse 154 series rev Oct 23 2008 and May 4 2010; 454 series revised 06/06/18): 4 A time-lag 454 fuse; 125 V DC; interrupting 50 A at 125 V DC and 300 A at 32 V DC; cold resistance 18.6 mΩ (was estimated ~15–25 mΩ); melting I²t 34.4 A²s; holder land pattern matches the KiCad footprint. 50 °C rerating is about 98 %, so 4 A × 0.75 × 0.98 ≈ 2.94 A continuous, above the 1.96 A worst case. | C206915 |
| D1 | SMBJ18A | Diode_SMD:D_SMB | SMBJ18A-13-F | Symbol Device:D_Zener (K=1 on VIN_PROT, A=2 on GND). No unidirectional TVS symbol is installed, and Device:D_TVS is bidirectional. TVS on the protected side of Q1. VERIFIED (Diodes DS19002 rev 20-2, May 2017, pp. 1, 3): VRWM 18 V; VBR 20.0–23.3 V; VC 29.2 V at 20.5 A; IR 5 µA max at VRWM (the shutdown budget holds, roll-up below); unidirectional, cathode band. | C135055 |
| D2 | BZT52C12 | Diode_SMD:D_SOD-123 | BZT52C12-7-F | Symbol Device:D_Zener (K=1 on VIN_PROT/source, A=2 on Q1_GATE). Q1 gate clamp, so the gate-source voltage magnitude stays at or below 12.7 V up to the 29 V clamp, under the 15 V target and Q1's 20 V absolute Vgs rating. VERIFIED (Diodes DS18004 rev 38-2, Oct 2017, p. 2): IR 0.1 µA at 8 V; 370 mW at 25 °C, ample for a ≤ 0.2 mA clamp (≈ 2.5 mW). Correction: Vz is 11.4–12.7 V at 5 mA (was taken as 12 V ±5 %). At 11.4 V min the R1 clamp current at 18 V is (18 − 11.4)/100 kΩ ≈ 66 µA, used in the shutdown roll-up below. | C124196 |
| D3 | B560C | Diode_SMD:D_SMC | B560C-13-F | Symbol Device:D_Schottky (K=1 on SW, A=2 on GND). Catch diode. VERIFIED (Diodes DS13012 rev 19-2, Oct 2026, p. 2): 5 A; 60 V VRRM (≥ 2× 29 V); VF 0.70 V max at 5 A; IR 0.5 mA max at 25 °C. IR rises to 20 mA max at 100 °C, a few hundred mW at most while switching, inside the thermal budget. It is seen only while switching, so it is not in the shutdown budget. | C85100 |
| D4 | Green | LED_SMD:LED_0603_1608Metric | 150060VS75000 | Symbol Device:LED (K=1 on GND, A=2 to R4). Power-present indicator on +5V, not power-good. VERIFIED (Würth WL-SMCW rev 002.009, 2019-02-26, pp. 1–3): green; 0603; pad 1 cathode. Correction: VF is specified at 20 mA (2.0 V typ, 2.4 V max), not at 2 mA. At the 2 mA operating point VF is about 1.9–2.0 V from the typical curve only (not a guaranteed limit), so the R4 current is ≈ 2.0–2.1 mA nominal and stays within 1–3 mA over Vout and resistor tolerance. Off when EN is low, since +5V collapses. | C6848499 |
| L1 | 15uH | Inductor_SMD:L_Bourns_SRP1245A | SRP1265A-150M | Symbol Device:L. Values fixed by the compensation constraint. No SRP1265A footprint is installed, so it uses the SRP1245A land pattern (same SRP12xx land; the SRP1265A body is 13.5 × 12.5 mm per Bourns SRP1265A rev 06/24, with the long side along the pad axis, inside the courtyard). Land pattern VERIFIED 2026-11-05: the SRP1265A and SRP1245A datasheets give the same recommended layout (14.2 mm overall, 8.0 mm gap, 5.0 mm pad width), and the KiCad pads are 3.1 × 5 mm at ±5.55 mm, which matches. Only the body height differs (SRP1265A 6.2 mm vs SRP1245A 4.8 mm); copper is unaffected. 3D model (change fix-3d-models-u1-l1-f1, 2026-11-06): the footprint now uses the EasyEDA/LCSC C189912 model ${KIPRJMOD}/lib/3d/l1/easyeda_l1.3dshapes/IND-SMD_L12.8-W13.5-H6.5.step (offset 0, rotation 0, lib/3d/README.md), so the stock 4.8 mm SRP1245A body no longer under-reports height. The community model is 6.5 mm tall, 0.3 mm above the 6.2 mm datasheet height; use the datasheet for enclosure clearance. Requirement: Isat > 6.0 A, the TPS5430 maximum current limit, so a current-limit event cannot saturate L1 (the ≈ 3.25 A peak at 3 A out stays below the 4.0 A minimum limit; corrected 2026-11-06, change review-docs-fab-notes, design review P.F1; the 6.0 A max is IHS(OC) max per TI SLVS632L rev L, p. 5, research/parts/datasheet-verification.md). Irms ≥ 4 A, DCR ≤ 35 mΩ. VERIFIED (Bourns SRP1265A rev 06/24, p. 1): 15 µH; Isat 12.5 A; Irms 9 A; DCR 28 mΩ max; recommended land pattern; 6.2 mm height. Correction: the body is 13.5 × 12.5 mm, not 12.5 × 12.5 mm. The long side runs along the pad axis and stays inside the footprint courtyard. | C189912 |
| FB1 | 0R | Resistor_SMD:R_2512_6332Metric | HCJ2512ZT0R00 | Symbol Device:R. EMI-filter series position, bridged in rev A, between VIN_PROT and VIN_BUCK. Stackpole HCJ 2512 high-current jumper, replacing RCL12250000Z0EG: the Vishay RCL1225 is a wide-terminal 1225 package that does not fit the R_2512 land (research/parts/jlcpcb-sourcing.md, Vishay RCL e3 rev 20-Oct-2025). VERIFIED (Stackpole SEI-HCJ rev 1/22/2025, pp. 1, 3): 63.2 A; ≤ 0.5 mΩ; 6.40 × 3.20 mm body (was quoted as 6.50 mm) with terminals on the short ends. Land pattern ACCEPTED FOR REV A: the KiCad R_2512_6332Metric pads (1.225 × 3.35 mm, 4.70 mm gap) are smaller than Stackpole's recommended 2.10 × 3.40 mm with a 3.80 mm gap, but the terminations still land fully on copper. Changing the footprint would rework the power-path copper; revisit if assembly reports poor fillets. That is far above the ≥ 4 A needed for the 4 A F1 (0154004.DRT) to open first. Backup: CRCW25120000Z0EGHP (C313993, 16 A). Generic ~2 A thick-film 2512 jumpers are rejected. The pad can later take a ferrite or inductor with damping. | C346503 |
| C1 | 10uF | Capacitor_SMD:C_1210_3225Metric | GRM32ER71H106KA12L | Symbol Device:C. Input bulk, VIN_BUCK to GND. VERIFIED (Murata GRM32ER71H106KA12L, updated 2013/10/01, pp. 1–2): 10 µF; 50 V (≥ 29 V clamp); X7R; 1210. Correction: about 7.4 µF effective at 18 V bias from the typical curve (was estimated ~5 µF). The datasheet gives no ripple-current rating; its temperature-rise curve gives about 3–4 °C at 2 A RMS, 500 kHz. Leakage negligible. | C77102 |
| C2 | 10uF | Capacitor_SMD:C_1210_3225Metric | GRM32ER71H106KA12L | Symbol Device:C. Second input capacitor, bulk input capacitance only: it sits about 12 mm from U1 on the VIN_BUCK trunk, so it does not share the ~1.5 A RMS input ripple equally with C1, which closes the primary input loop about 1.6 mm from U1 pin 7 (change review-docs-fab-notes, 2026-11-06, design review R.F1/P.F2, accepted for rev A; rev B candidate to move D3 or C1, docs/LAYOUT.md). VERIFIED as C1 (Murata GRM32ER71H106KA12L, updated 2013/10/01, pp. 1–2): 10 µF 50 V X7R 1210; about 7.4 µF effective at 18 V bias from the typical curve. C1 alone at ~1.5 A RMS stays under the 3–4 °C the temperature-rise curve gives at 2 A RMS. | C77102 |
| C3 | 100nF | Capacitor_SMD:C_0603_1608Metric | CC0603KRX7R9BB104 | Symbol Device:C. Local HF bypass at U1 VIN, inside the VIN–C3–U1–D3 loop. Yageo JLCPCB Basic part replacing GRM188R71H104KA93D with the same 100 nF, 50 V, X7R, ±10 %, 0603 ratings (research/parts/jlcpcb-sourcing.md). VERIFIED (Yageo spec sheet generated 11/06/2026, p. 1): 100 nF 10 % 50 V X7R 0603. | C14663 |
| C4 | 10nF | Capacitor_SMD:C_0603_1608Metric | 0603B103K500NT | Symbol Device:C. Bootstrap, BOOT to SW (PH). FH (Fenghua) JLCPCB Basic part replacing GRM188R71H103KA01D with the same 10 nF, 50 V, X7R, ±10 %, 0603 ratings (research/parts/jlcpcb-sourcing.md). VERIFIED (Fenghua MLCC-X7R, no revision printed, pp. 1, 2, 4): 10 nF 10 % 50 V X7R 0603. Value per TPS5430 datasheet (10 nF). | C57112 |
| C5 | 220uF | Capacitor_SMD:CP_Elec_8x10 | EEH-ZA1E221P | Symbol Device:C_Polarized (pin 1 = + on +5V). Hybrid output capacitor, value and ESR fixed by the compensation constraint. Replaces EEH-ZA1A221P, which is not on LCSC (research/parts/jlcpcb-sourcing.md): same Panasonic ZA series and 220 µF, 25 V instead of 10 V. Compensation re-check (`power.output_filter_compensation`): ESR 27 mΩ vs ~30 mΩ moves the ESR zero from ~24 kHz to ~27 kHz, with the LC pole unchanged at ~2.6 kHz. That stays close to TI's 5 V reference filter. Ripple is ≈ 0.48 A × 27 mΩ ≈ 13 mVpp (≤ 50 mVpp), and ESR is under the ≈ 40 mΩ limit from TI SLVS632L eq. 9, ESRmax = 1/(2π · Cout · fco) at ≈ 18 kHz (corrected from ~80 mΩ by change docs-rev-e-record-corrections, finding BR-B). The compensation check against eqs. 7–9 gives fco ≈ 16 kHz with C5 + C6 = 242 µF, inside 3–30 kHz, and an ESR zero ≈ 27 kHz. VERIFIED (Panasonic ZA series 04 Mar 2015, pp. 1–2): 220 µF; 25 V; ESR 27 mΩ at 100 kHz, 20 °C; 2.3 A RMS ripple rating (far above the ~0.14 A RMS output ripple); case 8 × 10.2 mm. Land pattern ACCEPTED FOR REV A: the KiCad CP_Elec_8x10 pads (3.5 × 2.5 mm) are slightly smaller than Panasonic's size-F land (4.0 × 2.0 mm, 3.1 mm gap; Panasonic HA series 01-Sep-25, p. 2), but the terminations still land fully on copper. Changing the footprint would rework the +5V copper; revisit if assembly reports poor fillets. Loop stability is still a bench check (DEVPLAN T6). | C341198 |
| C6 | 22uF | Capacitor_SMD:C_1210_3225Metric | GRM32ER71E226KE15L | Symbol Device:C. Output ceramic bypass, fixed by the compensation constraint; do not add more. Replaces GRM32ER71A226KE20L, which has 0 stock (research/parts/jlcpcb-sourcing.md): same 22 µF X7R 1210, 25 V instead of 10 V. It loses less capacitance at 5 V bias, so effective output C rises by a few µF and the LC pole moves down slightly (still ≈ 2.6 kHz). It is still one ceramic. VERIFIED (Murata GRM32ER71E226KE15L, updated 11/08/2020, pp. 2–3): 22 µF; 25 V; X7R; 1210. About 17.5–18 µF effective at 5 V bias from the typical curve, so total output C is ≈ 238 µF with C5 and the LC pole is ≈ 2.7 kHz, still close to TI's 5 V reference filter (`power.output_filter_compensation`). | C21397 |
| C7 | DNP | Capacitor_SMD:C_1210_3225Metric | — | Symbol Device:C. EMI π-filter input shunt (VIN_PROT to GND), not fitted (DNP) in rev A to E, because rev A ships with the input filter bridged by FB1 (docs/BRIEF.md Parts). If fitted later, use a 50 V X7R 1210 and add damping. MPN is the no-part marker (change bom-dnp-no-part-marker, rev E E11) so `copperhead export bom` leaves it out of the assembly BOM. No LCSC number, because it is not fitted. |  |
| C8 | DNP | Capacitor_SMD:C_1210_3225Metric | — | Symbol Device:C. EMI π-filter output shunt (VIN_BUCK to GND), not fitted (DNP) in rev A to E, because the input filter is bridged by FB1. Same rules as C7. MPN is the no-part marker (change bom-dnp-no-part-marker, rev E E11) so `copperhead export bom` leaves it out of the assembly BOM. No LCSC number, because it is not fitted. |  |
| C9 | 1nF | Capacitor_SMD:C_0603_1608Metric | CL10B102KB8NNNC | Symbol Device:C (pin 1 on EN, pin 2 on GND). EN-to-GND noise filter, FITTED in rev A (change fit-c9-en-filter, 2026-11-06; docs/BRIEF.md Assumptions, design review finding P.F3/S.F1). U1 ENA is held high only by its internal 1.5 MΩ pull-up and is wired off-board through J3, so switching noise or a field-wire transient could otherwise turn the converter off. Samsung 1 nF, ±10 %, 50 V, X7R, 0603 (research/parts/jlcpcb-sourcing.md). VERIFIED (research/parts/datasheet-verification.md; Samsung Electro-Mechanics product page and spec sheet for CL10B102KB8NNN, generated 2026-11-06, p. 1): 1.0 nF; ±10 %; 50 V DC; X7R (−55 to +125 °C); 0603 (1.60 × 0.80 × 0.80 mm); mass production. The trailing C in the MPN is the packaging code. A capacitor cannot pull EN high, so `protection.ena_pin_max_V` holds, and it is not the resistor to GND that the TPS5430 datasheet forbids. Leakage is a typical-behaviour estimate for X7R (nA class), not a verified datasheet figure; it is negligible against the 1 mA shutdown budget. 50 V on a pin below 7 V meets the 1.5× derating. With the 1.5 MΩ pull-up it adds an enable delay of about τ ≈ 1.5 ms, harmless at start-up. Board footprint is no longer excluded from the pick-and-place file. | C1588 |
| C10 | 100uF | Capacitor_SMD:CP_Elec_8x10 | — | Symbol Device:C_Polarized (pin 1 = + on VIN_BUCK, pin 2 on GND). Bulk input capacitor footprint on the converter input, added in rev E (change rev-e-en-series-bulk-cap-gnd-probe, rev E proposal E7; docs/BRIEF.md Parts, decided 2026-11-06; TPS5430 datasheet §7.3 recommends about 100 µF bulk when the source is more than a few inches away). Intended part Panasonic EEE-FK1H101P, 100 µF ±20 %, 50 V, FK series, size F 8 × 10.2 mm, LCSC C178548 (research/parts/input-bulk-capacitor.md). Not fitted (DNP) in rev E until the rev D hot-plug test shows whether the field-wired input needs the damping. Its ESR would also damp the optional π filter if C7, C8 and a series inductor were ever fitted. 50 V is above the 29 V TVS clamp and 1.5 × 18 V (`components.voltage_derating`). Same case as C5, so it uses the CP_Elec_8x10 land already checked for C5. MPN is the no-part marker, like J3, C7 and C8, so `copperhead export bom` leaves it out of the assembly BOM; the board footprint carries `exclude_from_pos_files`. If fitted later, set the MPN and LCSC cells and remove `exclude_from_pos_files`. No LCSC number in the cell, because it is not fitted. |  |
| R1 | 100k | Resistor_SMD:R_0603_1608Metric | 0603WAF1003T5E | Symbol Device:R. Q1 gate pull-down (Q1_GATE to GND). Its current equals the D2 current, max(0, Vin − Vz)/100 kΩ: at most 66 µA at 18 V (Vz 11.4 V min), none on reverse input (finding B.F1); it counts toward the shutdown budget. UniOhm JLCPCB Basic part replacing RC0603FR-07100KL with the same 100 k, 1 %, 0603 ratings (research/parts/jlcpcb-sourcing.md). VERIFIED (Uniroyal thick film V.3, Feb 12 2019, pp. 2, 4–6): 100 k; 1 %; 0603; 0.1 W at 70 °C. TCR ±100 ppm/°C, irrelevant for a pull-down. | C25803 |
| R2 | 10.0k | Resistor_SMD:R_0603_1608Metric | RT0603BRD0710KL | Symbol Device:R. Feedback top (+5V at C5 to FB). Replaces RT0603DRE0710KL with a Yageo 0.1 %, 25 ppm/°C part matched with R3 (research/parts/jlcpcb-sourcing.md). That is tighter than the 0.5 % the design needs (itself a deviation from the brief's 1 %) to hold ±3 % Vout. Divider error falls to ≈ ±0.15 %. VERIFIED (Yageo RT series V.17, Feb 12 2026, pp. 2, 4–6): 10.0 k; 0.1 % (B); 25 ppm/°C (D); 0603. In the part number R is the packaging code and D the TCR code. | C95204 |
| R3 | 3.24k | Resistor_SMD:R_0603_1608Metric | RT0603BRD073K24L | Symbol Device:R. Feedback bottom (FB to GND). Gives 4.990 V setpoint. Replaces RT0603DRE073K24L, which has 0 stock (research/parts/jlcpcb-sourcing.md): same value, 0.1 % instead of 0.5 %, 25 ppm/°C. VERIFIED (Yageo RT series V.17, Feb 12 2026, pp. 2, 4–6): 3.24 k; 0.1 % (B); 25 ppm/°C (D); 0603. | C728589 |
| R4 | 1.5k | Resistor_SMD:R_0603_1608Metric | 0603WAF1501T5E | Symbol Device:R. LED series resistor, +5V to D4 anode: (4.99 − 1.95)/1.5 k ≈ 2.0 mA nominal, using the D4 typical-curve VF of 1.9–2.0 V at 2 mA. Over Vout 4.85–5.15 V and 1 % tolerance the current spans ≈ 1.9–2.2 mA, within 1–3 mA. Even at the 2.4 V VF guaranteed only at 20 mA it would be ≥ 1.6 mA. UniOhm JLCPCB Basic part replacing RC0603FR-071K5L with the same 1.5 k, 1 %, 0603 ratings (research/parts/jlcpcb-sourcing.md). VERIFIED (Uniroyal thick film V.3, Feb 12 2019, pp. 2, 4–6): 1.5 k; 1 %; 0603; 0.1 W at 70 °C. | C22843 |
| R5 | 0R | Resistor_SMD:R_0603_1608Metric | 0603WAF0000T5E | Symbol Device:R (pin 1 on EN_EXT at J3/TP7, pin 2 on EN at U1.5/C9). Series position between the external enable pads and the TPS5430 ENA pin, added in rev E (change rev-e-en-series-bulk-cap-gnd-probe, rev E proposal E10; docs/BRIEF.md Interfaces and Assumptions, decided 2026-11-06). Fitted with 0 Ω because what drives EN and whether its wiring leaves the cabinet are still unknown; an ESD or current-limiting resistor can replace it later without a new layout. It is a series element only, never a pull-up or a resistor to GND, so `protection.ena_pin_max_V` holds and the datasheet's no-resistor-to-GND rule is respected. A future series resistor must stay small against the 1.5 MΩ internal pull-up so a dry contact still pulls ENA below its threshold. Uniroyal (UniOhm) 0603 jumper, JLCPCB Basic part (LCSC C21189). VERIFIED (research/parts/datasheet-verification.md R5 row; Uniroyal Thick Film Chip Resistors SMD-SP-001 version 9, Jun. 21 2025, section 7 Ratings, read 2026-11-06 via LCSC C21189): 0603 jumper, resistance < 50 mΩ, rated current 1 A, maximum overload current 2 A, −55 to +155 °C. It carries only the µA-class EN pull-up current, so the 1 A rating has a margin of several orders of magnitude. R5 must be fitted: it is the only link from J3/TP7 (EN_EXT) to U1 EN (change docs-r5-verified-t10-idss-d3-thermal). | C21189 |
| J1 | MKDS1.5/2-5.08 | TerminalBlock_Phoenix:TerminalBlock_Phoenix_MKDS-1,5-2-5.08_1x02_P5.08mm_Horizontal | 1715721 | Symbol Connector:Screw_Terminal_01x02 (pin 1 = VIN_RAW, pin 2 = GND). Replaces the brief's Würth 691137710002 because no Würth footprint is installed. Through-hole, so it needs JLCPCB through-hole assembly or hand soldering (research/parts/jlcpcb-sourcing.md). VERIFIED (Phoenix 1715721 datasheet 12/21/2021, pp. 1–3, 7–8): 2 positions; 5.08 mm; IEC 17.5 A (≥ 4.5 A), 250 V (III/3), 400 V (III/2); UL 300 V, 10–15 A (≥ 4.5 A); 0.14–1.5 mm² flexible wire. Pin 0.9 × 0.9 mm; Phoenix's recommended 1.3 mm hole matches the footprint's 1.3 mm drill. The square pin leaves little clearance in a 1.3 mm finished hole, so the fab must hold the finished hole size. | C480516 |
| J2 | MKDS1.5/2-5.08 | TerminalBlock_Phoenix:TerminalBlock_Phoenix_MKDS-1,5-2-5.08_1x02_P5.08mm_Horizontal | 1715721 | Symbol Connector:Screw_Terminal_01x02 (pin 1 = +5V, pin 2 = GND). Carries 3 A output. Same substitution and through-hole assembly note as J1. VERIFIED as J1 (Phoenix 1715721 datasheet 12/21/2021, pp. 1–3, 7–8): IEC 17.5 A, 250 V (III/3); UL 300 V, 10–15 A (≥ 4.5 A); 1.3 mm drill matches Phoenix's recommended hole, and the fab must hold the finished hole size. | C480516 |
| J3 | EN | Connector_PinHeader_2.54mm:PinHeader_1x02_P2.54mm_Vertical | — | Symbol Connector_Generic:Conn_01x02 (pin 1 = EN, pin 2 = GND). External enable pads: open = run, short to GND = off. Dry contact or open-drain to GND only; never drive high. Not fitted (DNP) in rev A to E: bare pads only, for the installer's contact wiring, with no external pull-up (intentional, `protection.ena_pin_max_V`). MPN is the no-part marker (change bom-dnp-no-part-marker, rev E E11) so `copperhead export bom` no longer emits it as a fitted line valued EN. No LCSC number, because it is not fitted. |  |
| TP1 | TP_VIN | TestPoint:TestPoint_Pad_D1.5mm | — | Symbol Connector:TestPoint. VIN_PROT. Bare pad, no part. |  |
| TP2 | TP_5V | TestPoint:TestPoint_Pad_D1.5mm | — | Symbol Connector:TestPoint. +5V. Bare pad, no part. |  |
| TP3 | TP_GND1 | TestPoint:TestPoint_Pad_D1.5mm | — | Symbol Connector:TestPoint. GND at J1. Bare pad, no part. |  |
| TP4 | TP_GND2 | TestPoint:TestPoint_Pad_D1.5mm | — | Symbol Connector:TestPoint. GND at J2. Bare pad, no part. |  |
| TP5 | TP_SW | TestPoint:TestPoint_Pad_1.0x1.0mm | — | Symbol Connector:TestPoint. SW. Small pad next to U1 so the switch-node copper does not grow. |  |
| TP6 | TP_FB | TestPoint:TestPoint_Pad_1.0x1.0mm | — | Symbol Connector:TestPoint. FB, placed at R2/R3 away from SW. |  |
| TP7 | TP_EN | TestPoint:TestPoint_Pad_D1.5mm | — | Symbol Connector:TestPoint. EN. Bare pad, no part. |  |
| TP8 | TP_GND3 | TestPoint:TestPoint_Pad_1.0x1.0mm | — | Symbol Connector:TestPoint. GND probe pad beside TP5 (SW) on the U1/D3 ground copper, added in rev E (change rev-e-en-series-bulk-cap-gnd-probe, rev E proposal E6; docs/BRIEF.md Interfaces; verification findings L.F1, S.F1) so the switch node can be probed with a scope ground spring. Bare pad, no part. Like TP1–TP7 its footprint carries `exclude_from_pos_files` only, not `exclude_from_bom`. |  |
| H1 | MountingHole_M3 | MountingHole:MountingHole_3.2mm_M3 | — | Symbol Mechanical:MountingHole (0 pins, no net). Non-plated 3.2 mm M3 hole at one board corner, per docs/BRIEF.md Physical and SPEC §6. A copper and component keepout of ≥ 3.5 mm radius surrounds it on both layers (`mech.board_mm`). It is unplated and unconnected on purpose, so the mount is not a GND path (SELV, shared ground). Not a placed part. |  |
| H2 | MountingHole_M3 | MountingHole:MountingHole_3.2mm_M3 | — | Symbol Mechanical:MountingHole (0 pins, no net). Second M3 hole at the diagonally opposite corner from H1, with the same ≥ 3.5 mm keepout and the same no-net rationale. Not a placed part. |  |

## Intentionally absent
- **R_en (EN pull-up): not fitted, on purpose.** The TPS5430 internal ENA pull-up gives default-on. A pull-up to VIN would exceed the ~7 V ENA abs max (`protection.ena_pin_max_V`). It is not an omission.
- **Power-good output:** none, because the TPS5430 has no PG pin (SPEC §8).

## Leakage and quiescent roll-up (datasheet figures VERIFIED 2026-11-06, research/parts/datasheet-verification.md)

| Part | Shutdown (EN low, 18 V in) | No-load (enabled, 12 V in) |
|---|---|---|
| U1 TPS5430 | ≤ 50 µA max shutdown (15 µA typ; TI SLVS632L rev L) | 4.4 mA max Iq (2 mA typ; was ~3 mA) + light-load switching loss of a few mA |
| D2 + R1 gate clamp | ≤ 66 µA, (18 V − 11.4 V Vz min)/100 kΩ (was 60 µA at 12 V nominal) | ≤ 6 µA, max(0, 12 V − 11.4 V)/100 kΩ; R1 carries the same current as D2 (the earlier 120 µA through R1 was wrong, finding B.F1) |
| D1 SMBJ18A | ≤ 5 µA max at VRWM (Diodes DS19002 rev 20-2) | ≤ 5 µA |
| C1, C2, C3 | negligible | negligible |
| C9 (fitted from change fit-c9-en-filter) | negligible (typical-behaviour estimate of nA-class X7R leakage on EN, < 7 V; part ratings VERIFIED, Samsung spec sheet 2026-11-06, but leakage is not a datasheet figure) | negligible |
| C10 (rev E, not fitted) | 0 (not fitted; add its datasheet leakage if ever fitted) | 0 |
| R5 0 Ω (rev E) | 0 (series element, no path to GND) | 0 |
| D4 + R4 LED | 0 (+5V is off) | 2 mA at 5 V ≈ 1.4 mA reflected to input |
| R2 + R3 divider | 0 | 0.38 mA at 5 V ≈ 0.3 mA reflected |
| **Total** | **≈ 0.121 mA worst case (50 + 66 + 5 µA) ≤ 1 mA: OK** | **≈ 7–11 mA worst case (4.4 mA Iq max + ~1.7 mA LED and divider + a few mA switching) ≤ 20 mA: OK, bench-verify (DEVPLAN T1)** |

Voltage derating (≥ 1.5×, and above the 29 V clamp on the input side): C1/C2/C3/C4/C7/C8 50 V; C10 (not fitted, EEE-FK1H101P) 50 V; C5/C6 25 V (≥ 7.7 V; raised from 10 V by the JLCPCB substitutions, research/parts/jlcpcb-sourcing.md); D3 60 V; Q1 60 V; FB1 is a jumper. All pass.
Current: J1/J2 IEC 17.5 A, UL 10–15 A (≥ 4.5 A); FB1 HCJ2512ZT0R00 63.2 A (≥ 4 A, coordinated with the 4 A F1); F1 4 A at 1.96 A worst-case (~49 %, ≤ 75 %), ≈ 2.94 A continuous at 50 °C after the ~98 % rerating; L1 Isat ≥ 6 A required, 12.5 A per Bourns SRP1265A rev 06/24 (> 4 A limit). All pass, VERIFIED against the datasheets in research/parts/datasheet-verification.md (2026-11-06).
