copperheadhq/copperhead-tps5430-buck-converter/3d/tps5430-buck-mechanical.step

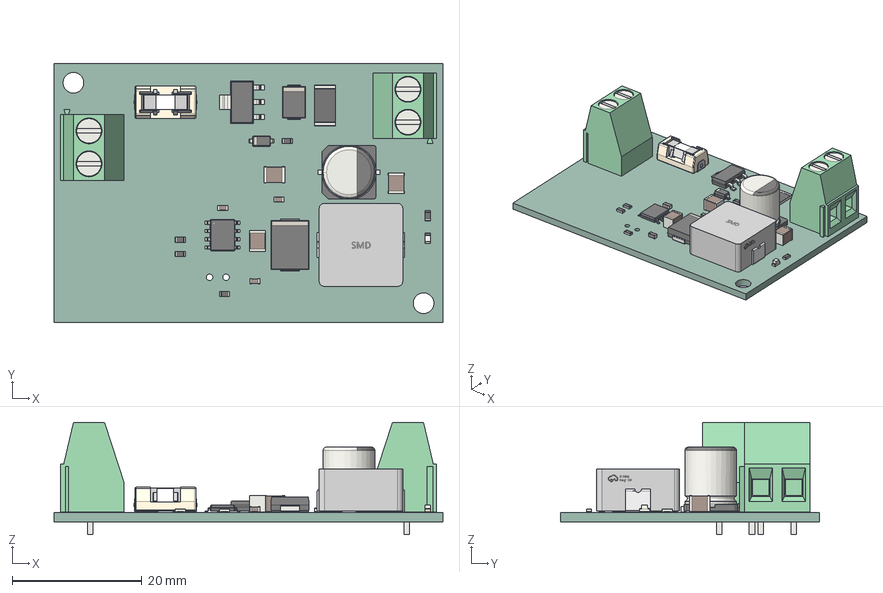
[picture p7: CAD file, 2026-11-07]
3d/tps5430-buck-mechanical.step
60.0 x 40.0 x 17.3 mm
TerminalBlock_Phoenix_MKDS-1,5-2-5.08_1x02_P5.08mm_Horizontal x 2
C_0603_1608Metric x 3
R_0603_1608Metric x 5
IND-SMD_L12.8-W13.5-H6.5
D_SOD-123
D_SMB
SOT-223
C_1210_3225Metric x 3
R_2512_6332Metric
LED_0603_1608Metric
TI_SO-PowerPAD-8
¼þ1
¼þ2 x 2
µ艝
CP_Elec_8x10
D_SMC
tps5430-12-v-to-5-v-industrial-buck-converter_PCB
