copperheadhq/copperhead-tps5430-buck-converter/3d/tps5430-buck-board-only.stl

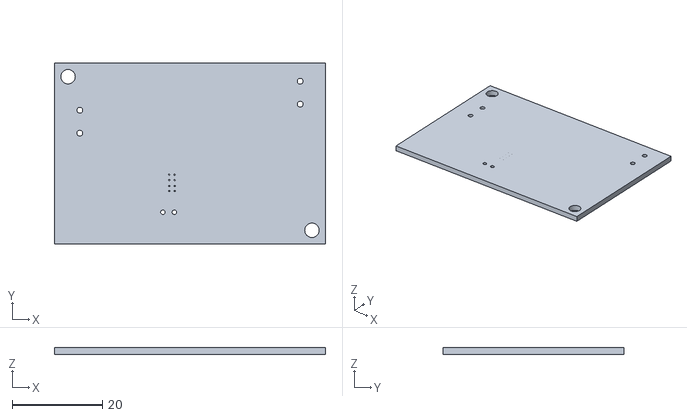
[picture p9: CAD file, 2026-11-06]
3d/tps5430-buck-board-only.stl
60.0 x 40.0 x 1.44
