copperheadhq/copperhead-tps5430-buck-converter/(list of files, cad)

Other CAD files:
3d/tps5430-buck.stl
