copperheadhq/copperhead-tps5430-buck-converter/docs/schematic.pdf

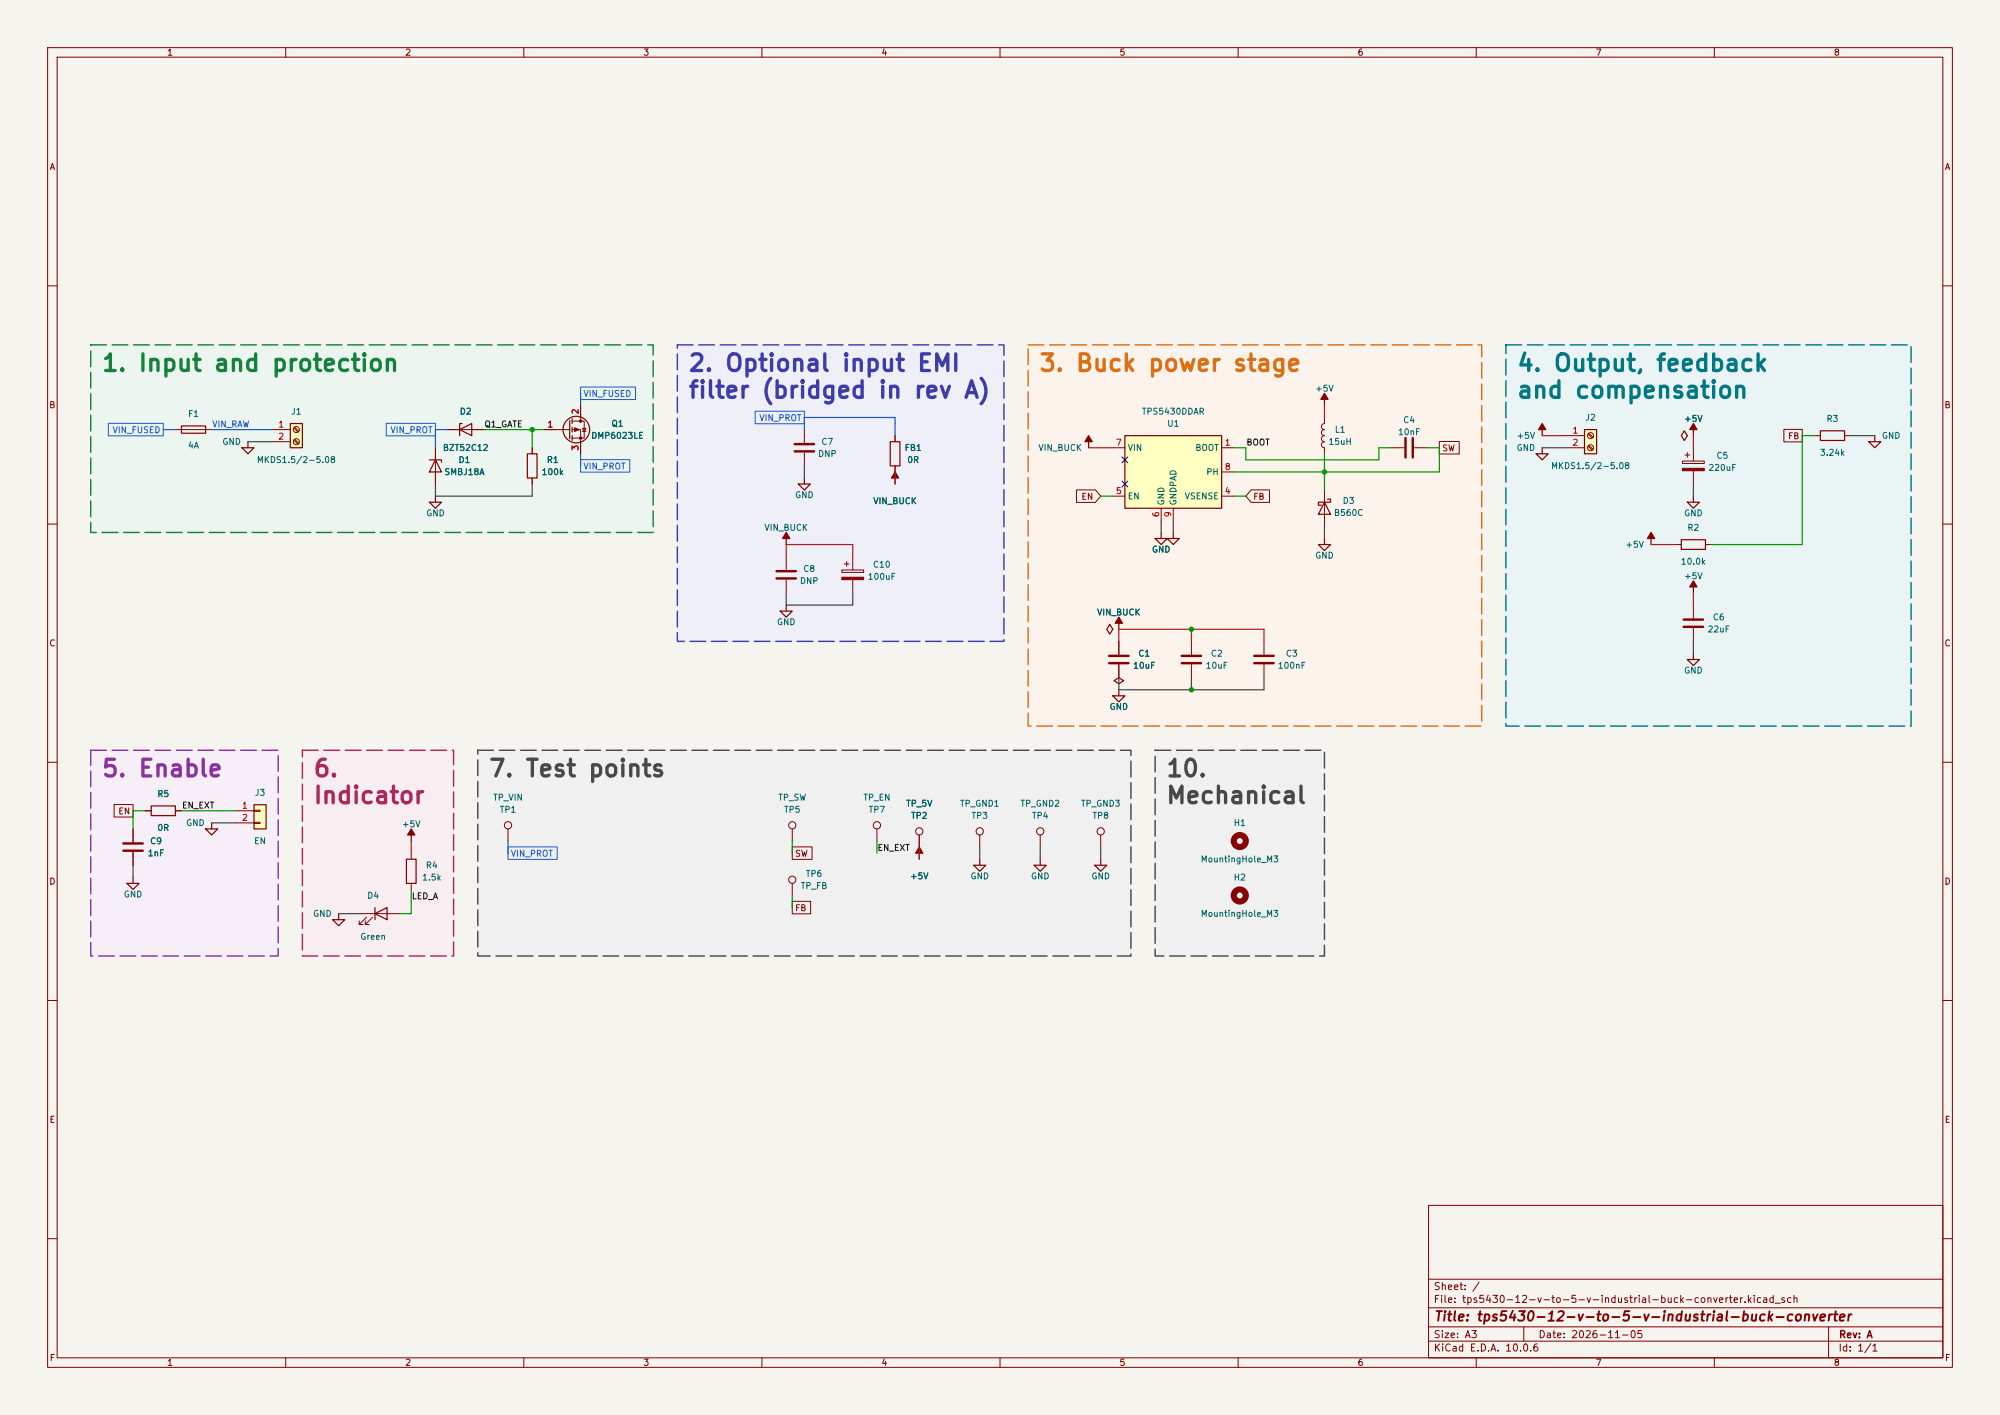
[picture p10: page 1]

BOOT 2. Optional input EMI
filter (bridged in rev A)

Sheet: /
File: tps5430-12-v-to-5-v-industrial-buck-converter.kicad_sch
Title: tps5430-12-v-to-5-v-industrial-buck-converter

Size: A3 | Rev: A | F Date: 2026-11-05
KiCad E.D.A. 10.0.6 | Id: 1/1
