copperheadhq/copperhead-tps5430-buck-converter/hardware/tps5430-12-v-to-5-v-industrial-buck-converter.kicad_pcb

## KiCad design hardware/tps5430-12-v-to-5-v-industrial-buck-converter.kicad_pcb (2026-11-07)

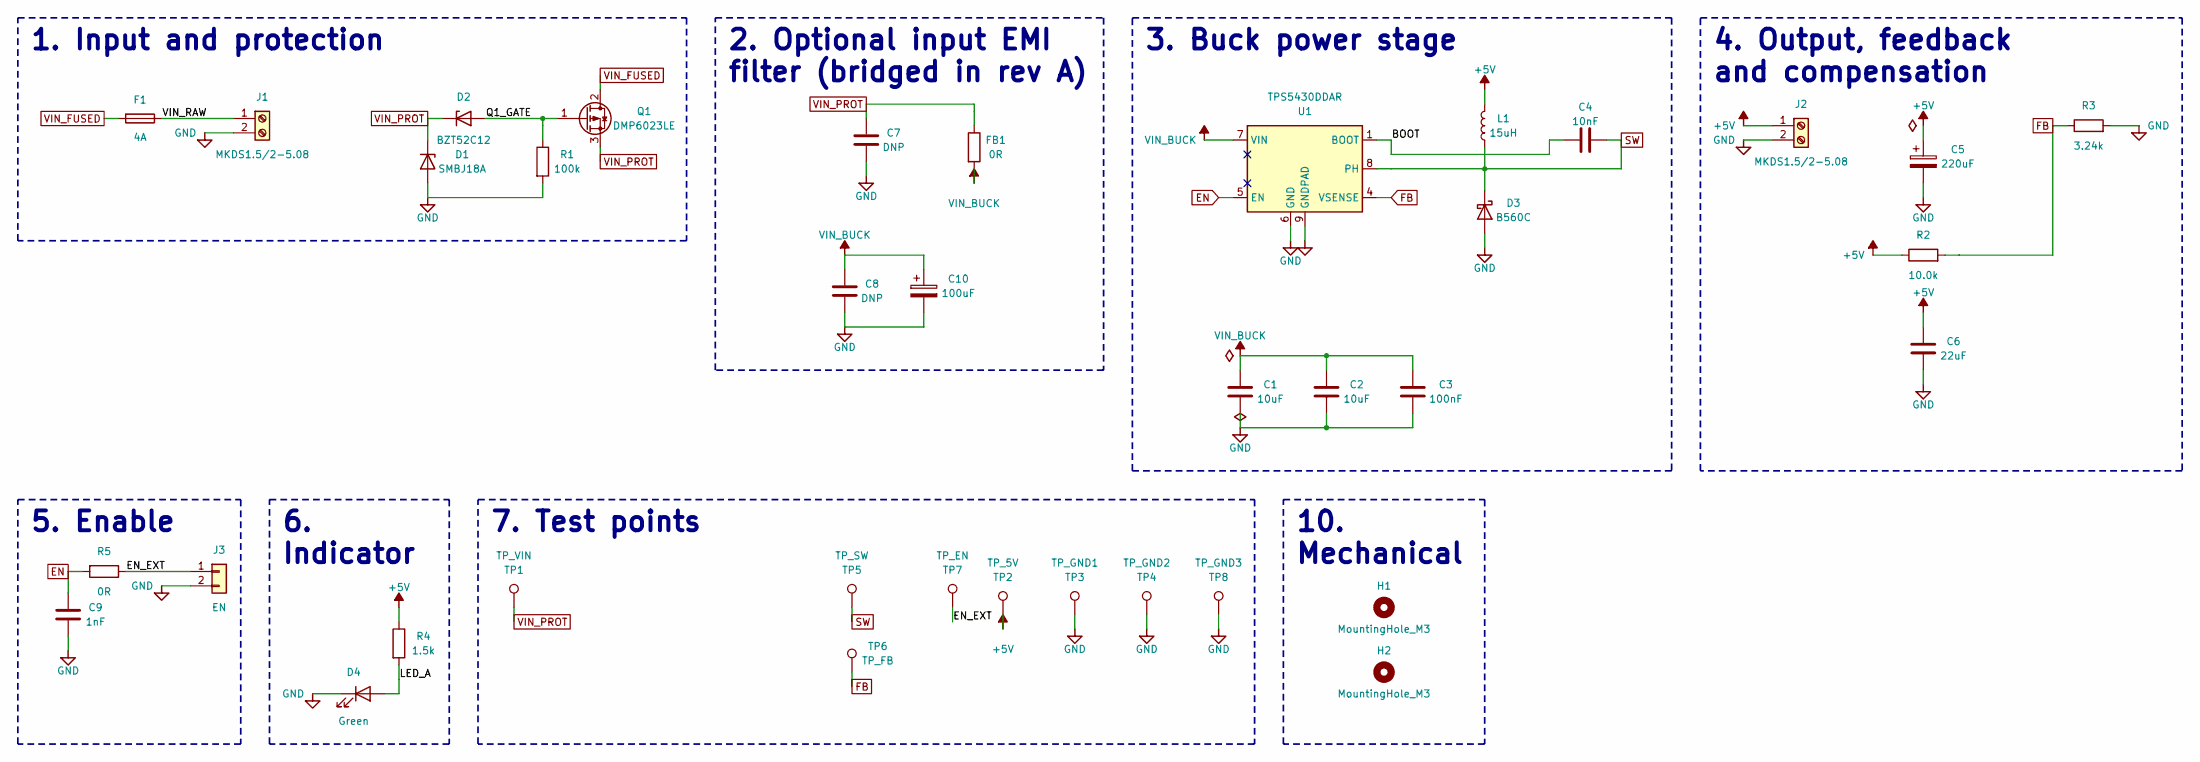
[picture p11: schematic tps5430-12-v-to-5-v-industrial-buck-converter.kicad_sch]

Parts:
C1, C2: 10uF; C_1210_3225Metric
C3: 100nF; C_0603_1608Metric
C4: 10nF; C_0603_1608Metric
C5: 220uF; CP_Elec_8x10
C6: 22uF; C_1210_3225Metric
C7, C8: DNP; C_1210_3225Metric
C9: 1nF; C_0603_1608Metric
C10: 100uF; CP_Elec_8x10
D1: SMBJ18A; D_SMB
D2: BZT52C12; D_SOD-123
D3: B560C; D_SMC
D4: Green; LED_0603_1608Metric
F1: 4A; Fuseholder_Littelfuse_Nano2_154x
FB1: 0R; R_2512_6332Metric
H1, H2: MountingHole_M3; MountingHole_3.2mm_M3
J1, J2: MKDS1.5/2-5.08; TerminalBlock_Phoenix_MKDS-1,5-2-5.08_1x02_P5.08mm_Horizont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
J3: EN; PinHeader_1x02_P2.54mm_Vertical
L1: 15uH; L_Bourns_SRP1245A
Q1: DMP6023LE; SOT-223-3_TabPin2
R1: 100k; R_0603_1608Metric
R2: 10.0k; R_0603_1608Metric
R3: 3.24k; R_0603_1608Metric
R4: 1.5k; R_0603_1608Metric
R5: 0R; R_0603_1608Metric
TP1: TP_VIN; TestPoint_Pad_D1.5mm
TP2: TP_5V; TestPoint_Pad_D1.5mm
TP3: TP_GND1; TestPoint_Pad_D1.5mm
TP4: TP_GND2; TestPoint_Pad_D1.5mm
TP5: TP_SW; TestPoint_Pad_1.0x1.0mm
TP6: TP_FB; TestPoint_Pad_1.0x1.0mm
TP7: TP_EN; TestPoint_Pad_D1.5mm
TP8: TP_GND3; TestPoint_Pad_1.0x1.0mm
U1: TPS5430DDAR; TI_SO-PowerPAD-8_ThermalVias

Connections:
+5V: C5.1, C6.1, J2.1, L1.2, R2.1, R4.1, TP2.1
/BOOT: C4.1, U1.1 (BOOT)
/EN_EXT: J3.1, R5.1, TP7.1
/LED_A: D4.2 (A), R4.2
/Q1_GATE: D2.2 (A), Q1.1 (G), R1.1
/VIN_RAW: F1.1, J1.1
EN: C9.1, R5.2, U1.5 (EN)
FB: R2.2, R3.1, TP6.1, U1.4 (VSENSE)
GND: C1.2, C2.2, C3.2, C5.2, C6.2, C7.2, C8.2, C9.2, C10.2, D1.2 (A), D3.2 (A), D4.1 (K), J1.2, J2.2, J3.2, R1.2, R3.2, TP3.1, TP4.1, TP8.1, U1.6 (GND), U1.9 (GNDPAD)
SW: C4.2, D3.1 (K), L1.1, TP5.1, U1.8 (PH)
VIN_BUCK: C1.1, C2.1, C3.1, C8.1, C10.1, FB1.2, U1.7 (VIN)
VIN_FUSED: F1.2, Q1.2 (D)
VIN_PROT: C7.1, D1.1 (K), D2.1 (K), FB1.1, Q1.3 (S), TP1.1

Notes on the sheet:
1. Input and protection
10. Mechanical
2. Optional input EMI filter (bridged in rev A)
3. Buck power stage
4. Output, feedback and compensation
5. Enable
6. Indicator
7. Test points

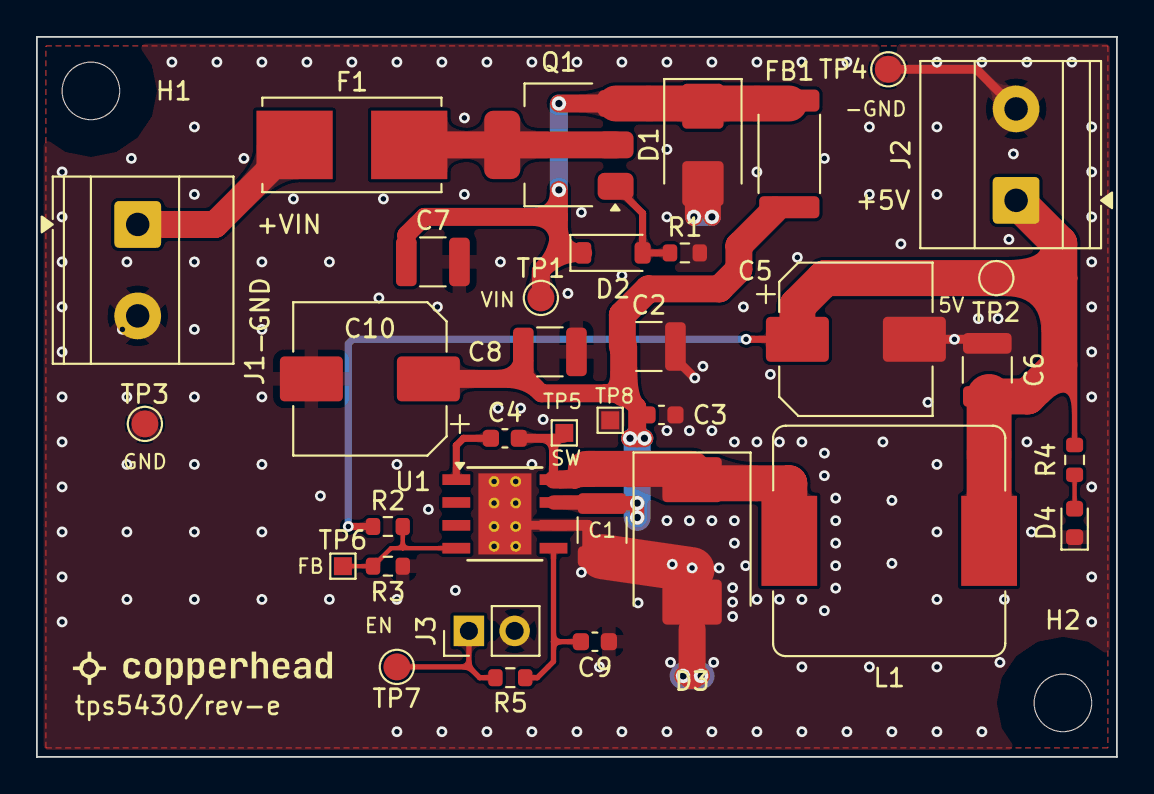
[picture p12: board tps5430-12-v-to-5-v-industrial-buck-converter.kicad_pcb from above]

Board: 2 copper layers, 60.0 x 40.0 mm, 37 parts (0 on the bottom side), 13 nets.
