copperheadhq/copperhead-tps5430-buck-converter/(commit log)

2026-11-06 Publish rev D of the TPS5430 12 V to 5 V industrial buck converter
    From the design workspace at release commit 1393414 (board unchanged
    since e03bac1). KiCad project in hardware/, design documents and brief
    in docs/, the frozen rev D fab files in fab/rev-d/, renders in images/,
    3D models in 3d/. Never built.
    [tps5430-12-v-to-5-v-industrial-buck-converter-B_Cu.gbl, tps5430-12-v-to-5-v-industrial-buck-converter-B_Mask.gbs, tps5430-12-v-to-5-v-industrial-buck-converter-B_Paste.gbp, tps5430-12-v-to-5-v-industrial-buck-converter-B_Silkscreen.gbo, tps5430-12-v-to-5-v-industrial-buck-converter-Edge_Cuts.gm1, tps5430-12-v-to-5-v-industrial-buck-converter-F_Cu.gtl, tps5430-12-v-to-5-v-industrial-buck-converter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]
2026-11-06 hardware: copperhead logo and tps5430/rev-d label on the front silkscreen
    The lockup (fiducial mark and wordmark, 14.4 x 1.86 mm, outlines from the
    STM32 data logger board) with the board name below it, in the lower-left
    corner. Silkscreen only; DRC with zone refill and parity stays at 0.
    Renders and 3D models re-exported. fab/rev-d/ and the release assets are
    the frozen rev D files and have no branding; the READMEs say so.
    [tps5430-12-v-to-5-v-industrial-buck-converter.kicad_pcb, tps5430-buck.step]
2026-11-06 hardware: schematic on A4 (blocks shelf-packed by size, layout only)
    Move the schematic from A3 to A4 landscape. The eight block boxes are
    packed in rows, largest first: EMI filter, buck stage and output on top;
    input, enable and mechanical in the middle; test points and indicator at
    the bottom, left of the title block. Each block moved as a unit on the
    1.27 mm grid. The seven test points are aligned in one row, TP1 to TP7.
    Layout only: ERC is clean and the netlist is identical to the A3 sheet
    (14 nets, same part pins). No part, value, footprint, PCB or fab file
    changed. docs/schematic.pdf and .svg are re-exported from the new sheet.
    copperhead's drafting engine cannot yet pack this sheet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
    [tps5430-12-v-to-5-v-industrial-buck-converter.kicad_sch]
2026-11-06 images: re-render the schematic preview from the A4 sheet
    The README preview still showed the A3 sheet. Re-rendered from
    docs/schematic.pdf at the same 2481 px width.
2026-11-07 rev E: hardware, docs, fabrication files, 3D models and renders
    Rev E of the board, from the design workspace's release commit c50e737
    (design at 116202e), released 2026-11-07. Never built; rev D was never
    built either.
    - hardware/: the rev E KiCad project (board, schematic, rules, vendored
    symbols and 3D models). The schematic is the released A3 sheet.
    - docs/: the rev E design documents, unedited; schematic PDF/SVG
    re-exported; BOARD-STATS regenerated (37 footprints, 23 fitted,
    178 vias, 48 teardrops, 23 fillets, 194 holes).
    - fab/rev-e/: byte-for-byte copies of the release gerbers, drill, job,
    BOM and placement files (SHA-256 checked against the release README),
    a gerber zip an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
    [tps5430-12-v-to-5-v-industrial-buck-converter-B_Cu.gbl, tps5430-12-v-to-5-v-industrial-buck-converter-B_Mask.gbs, tps5430-12-v-to-5-v-industrial-buck-converter-B_Paste.gbp, tps5430-12-v-to-5-v-industrial-buck-converter-B_Silkscreen.gbo, tps5430-12-v-to-5-v-industrial-buck-converter-Edge_Cuts.gm1, tps5430-12-v-to-5-v-industrial-buck-converter-F_Cu.gtl, tps5430-12-v-to-5-v-industrial-buck-converter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]
2026-11-09 images, 3d: show every part in the renders and add an assembled STL
    Re-render board-front, board-back and board-angle with C7, C8, C10 and J3
    drawn (they were hidden as not fitted) on a plain white background; the
    old front render had floor-shadow ghosts. Captions say those four are not
    fitted on assembled rev E boards.
    Add 3d/tps5430-buck.stl, the assembled board as one binary mesh, so
    GitHub's 3D viewer shows the parts; the only STL before was the bare
    board outline. STEP and GLB models and fab/ are unchanged.
    [tps5430-buck.stl]
